Kannospark/Eco-friendly-racing-cars/Final Report & Experience/Study Note/week2/Week_2_Study_Note.pdf

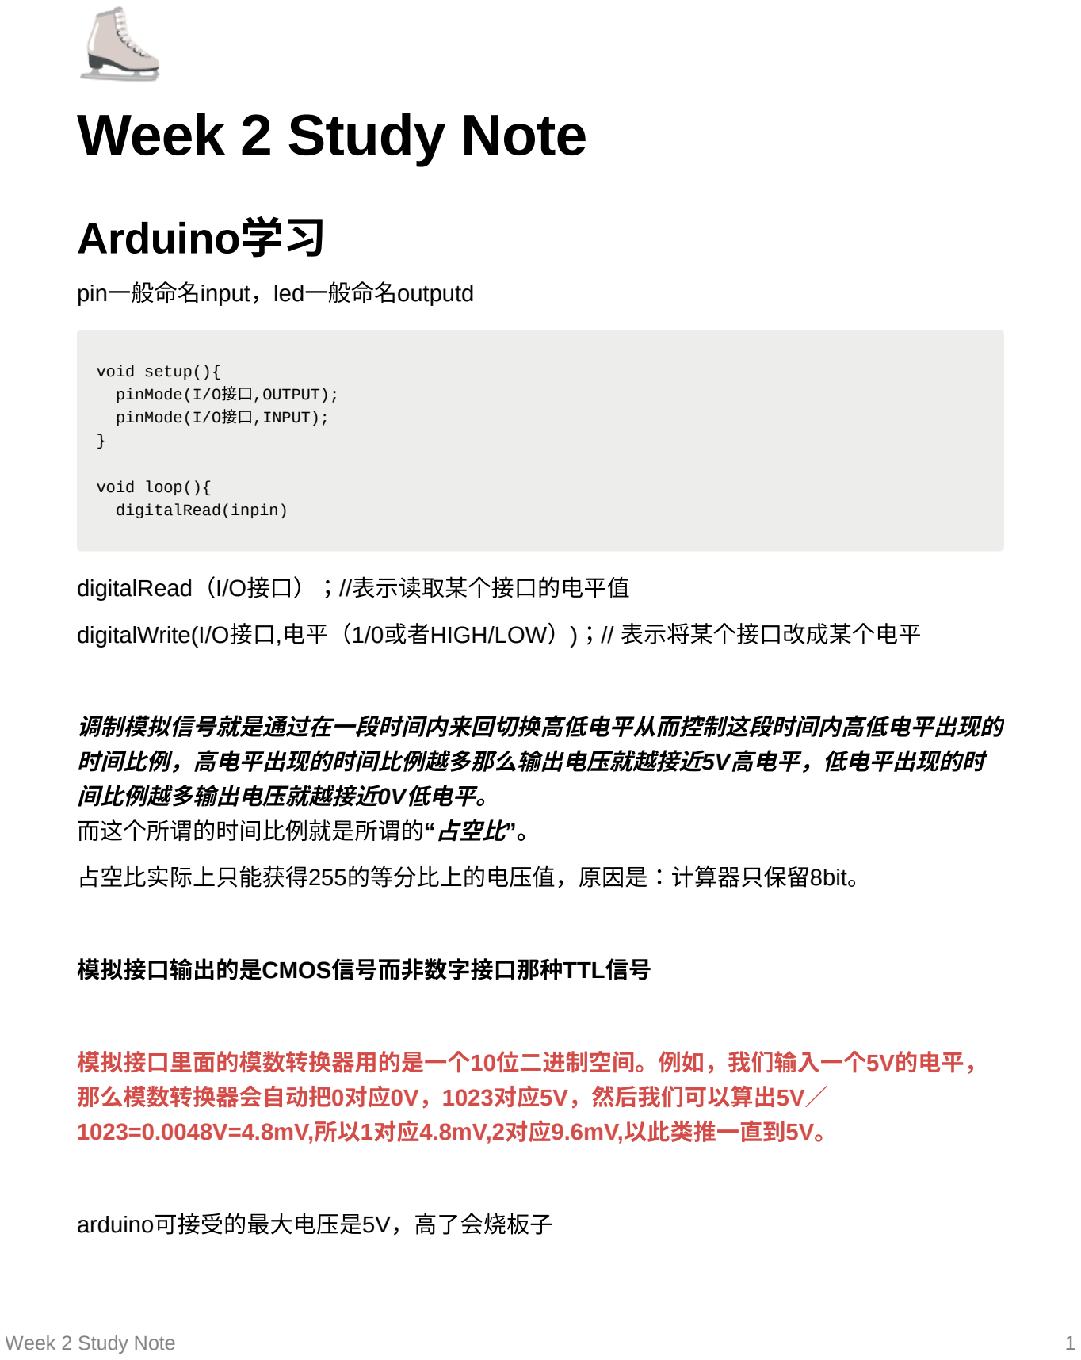
[picture p2: figure]
Week 2 Study Note; Arduino学习; pin⼀般命名input，led⼀般命名outputd; void setup(){ pinMode(I/O接⼝,OUTPUT); pinMode(I/O接⼝,INPUT);; void loop(){ digitalRead(inpin); digitalRead（I/O接⼝）；//表⽰读取某个接⼝的电平值; digitalWrite(I/O接⼝,电平（1/0或者HIGH/LOW）)；// 表⽰将某个接⼝改成某个电平; 调制模拟信号就是通过在⼀段时间内来回切换⾼低电平从⽽控制这段时间内⾼低电平出现的 时间⽐例，⾼电平出现的时间⽐例越多那么输出电压就越接近5V⾼电平，低电平出现的时; 间⽐例越多输出电压就越接近0V低电平。; ⽽这个所谓的时间⽐例就是所谓的“占空⽐”。; 占空⽐实际上只能获得255的等分⽐上的电压值，原因是：计算器只保留8bit。; 模拟接⼝输出的是CMOS信号⽽⾮数字接⼝那种TTL信号; 模拟接⼝⾥⾯的模数转换器⽤的是⼀个10位⼆进制空间。例如，我们输⼊⼀个5V的电平，; 那么模数转换器会⾃动把0对应0V，1023对应5V，然后我们可以算出5V∕ 1023=0.0048V=4.8mV,所以1对应4.8mV,2对应9.6mV,以此类推⼀直到5V。; arduino可接受的最⼤电压是5V，⾼了会烧板⼦

val = analogRead(potpin);//读取传感器的模拟值并赋给val（即将模拟端⼝的电平给val）

波特率也称调制速率是每秒传输的⼆进制数据数⽬，速率是bps，同波特率才可以实现串⼝ 通信

每秒通过信道传输的码元数（码元传输速率），通过不同的调制⽅法可以在⼀个码元上负载 多个⽐特信息 数据信号对载波的调制速率

“波特率”表⽰每秒种传输离散信号事件的个数，或每秒信号电平的变化次数，单位为 band（波特）。即波特率所表⽰的是调制速度，是单位时间内传输线路上调制状态的变化 数。

调制后同⼀时间⾥所包含的数据数量，波特率不同的话数据采集会出错，在单⽚机中若晶振 (https://so.csdn.net/so/search?q=%E5%8D%95%E7%89%87%E6%9C%BA&spm=1001.2101.3001.7020) 采集速度不够的话也会出现数据错误

Serial.begin(); //开启串⾏通信接⼝并设置通信波特率

## ⼩⻋电控遇⻅的问题以及初步解决⽅案

后续想要实现遥控器（⼿柄）控制电机的转速，需要⽤到H桥、控制电路以及升压器。⽬前 组内有很多低内阻（0.1欧）直流电机⽆法使⽤，原因是供电充电宝电压太低导致电流过 ⼤，直流电机⽆法带动。后续需要升压模块进⾏升压。

## 回答SA上课时的⼀些问题

### Question 1 - 第⼀个指令中9600代表波特率。请弄清楚波特率是什么。

void setup(){
Serial.begin(9600);
Serial.println("Hello, SDIM!"); }
- 串⾏通信不是⾃计时的（不同于SPI或I2C等），因此发送⽅和接收⽅都必须就时钟速率达 成共识。

波特率是串⼝通信时的⼀个参数，决定信息传输的速率。9600意味着每秒传输9600个⼆进 制位数、每个数据字节=10⼆进制，所以等于960字节/秒。由于我们默认⼀般都是

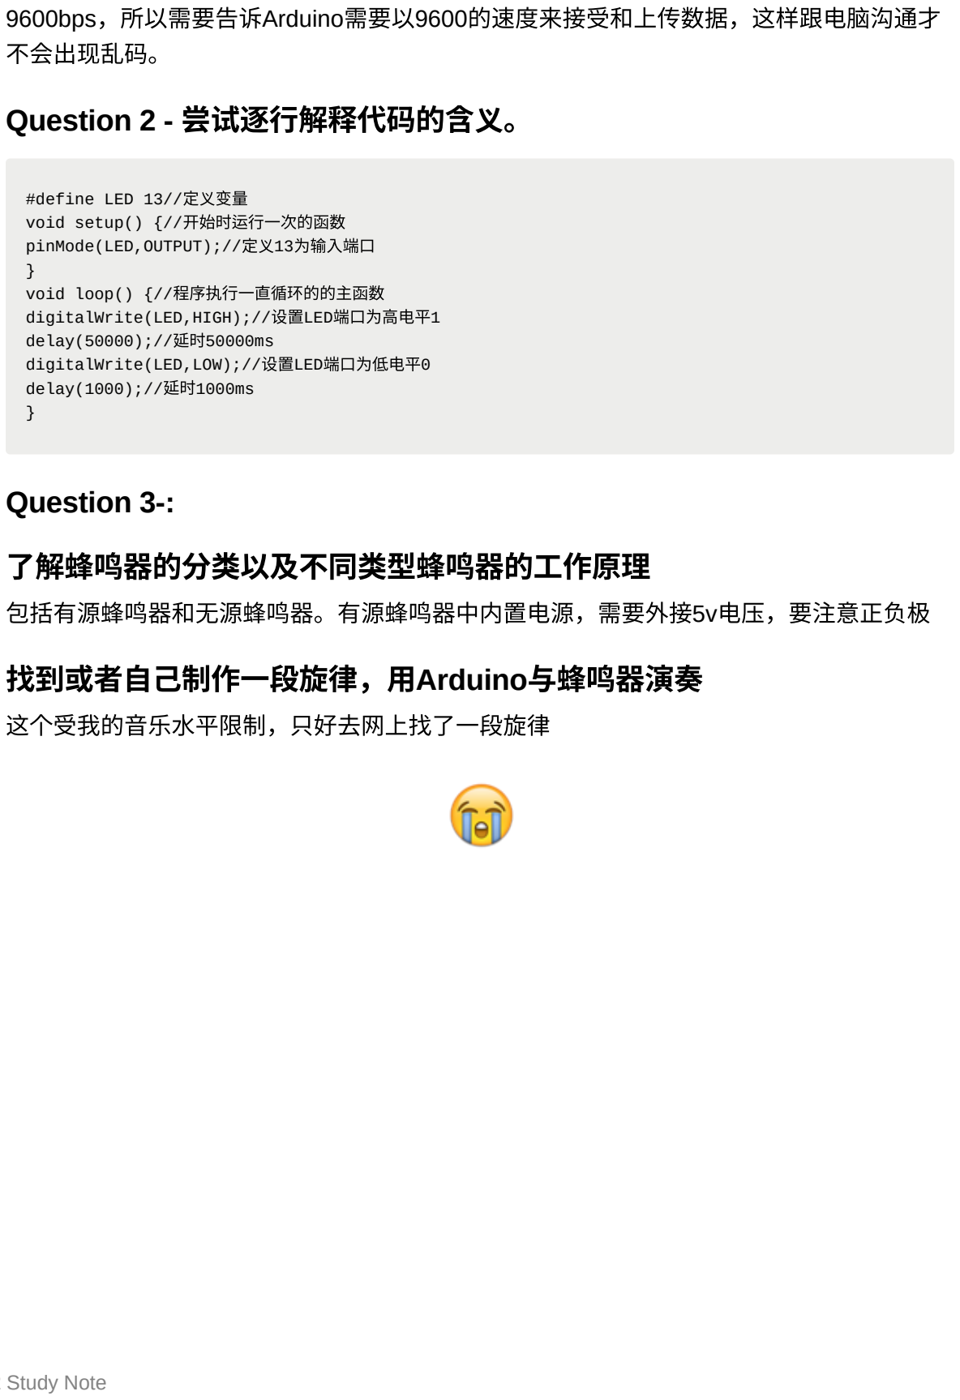
[picture p3: figure]
9600bps，所以需要告诉Arduino需要以9600的速度来接受和上传数据，这样跟电脑沟通才; 不会出现乱码。; Question 2 - 尝试逐⾏解释代码的含义。; #define LED 13//定义变量 void setup() {//开始时运⾏⼀次的函数 pinMode(LED,OUTPUT);//定义13为输⼊端⼝ } void loop() {//程序执⾏⼀直循环的的主函数 digitalWrite(LED,HIGH);//设置LED端⼝为⾼电平1 delay(50000);//延时50000ms digitalWrite(LED,LOW);//设置LED端⼝为低电平0 delay(1000);//延时1000ms }; Question 3-:; 了解蜂鸣器的分类以及不同类型蜂鸣器的⼯作原理; 包括有源蜂鸣器和⽆源蜂鸣器。有源蜂鸣器中内置电源，需要外接5v电压，要注意正负极; 找到或者⾃⼰制作⼀段旋律，⽤Arduino与蜂鸣器演奏; 这个受我的⾳乐⽔平限制，只好去⽹上找了⼀段旋律

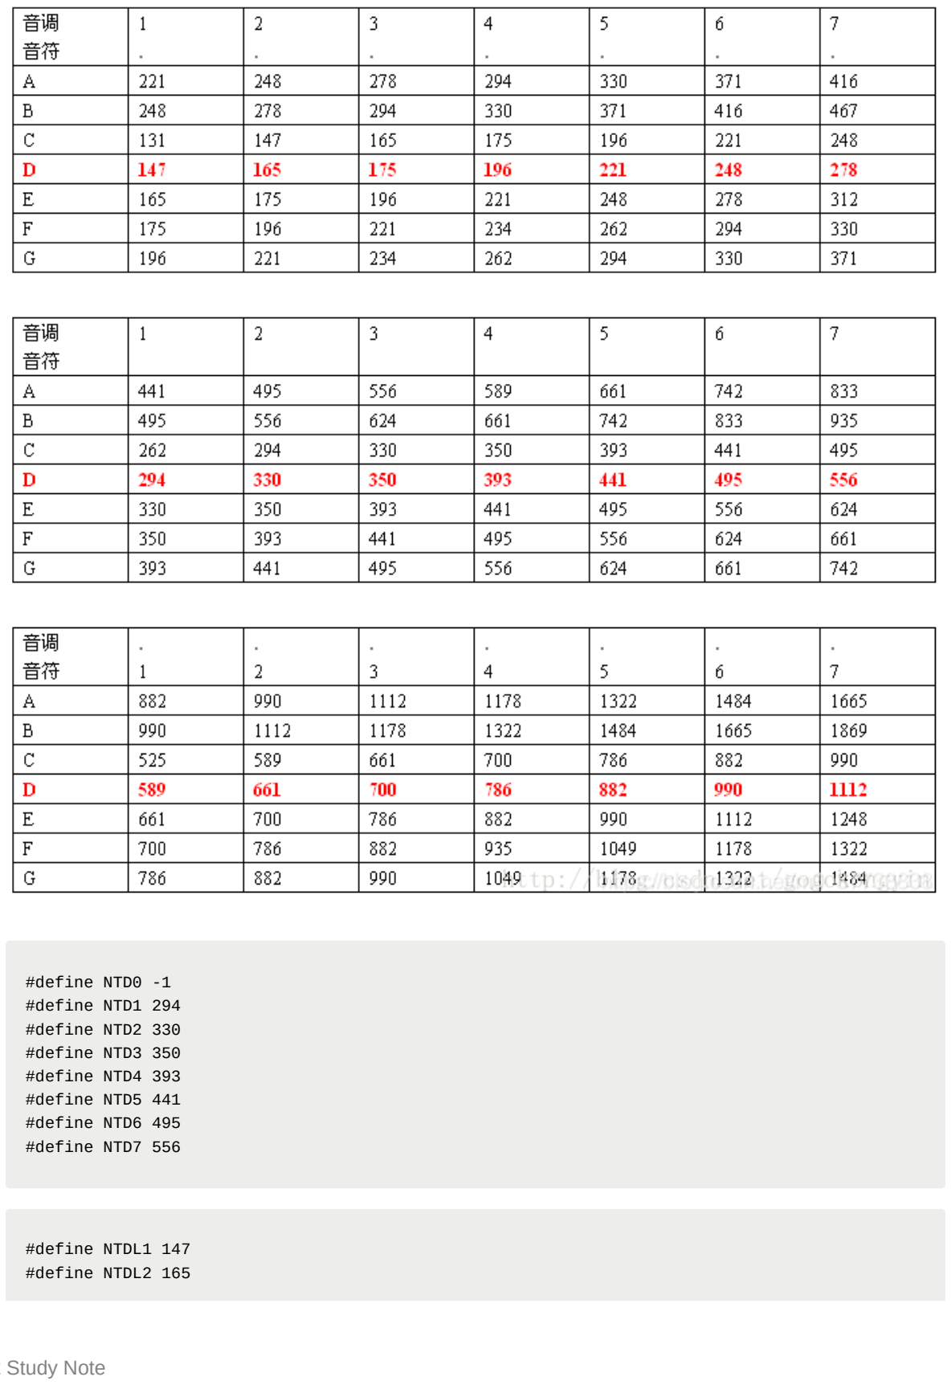
[picture p4: figure]
#define NTD0 -1 #define NTD1 294 #define NTD2 330 #define NTD3 350 #define NTD4 393 #define NTD5 441 #define NTD6 495 #define NTD7 556; #define NTDL1 147 #define NTDL2 165

#define NTDL3 175

#define NTDL4 196

#define NTDL5 221

#define NTDL6 248

#define NTDL7 278

#define NTDH1 589

#define NTDH2 661

#define NTDH3 700

#define NTDH4 786

#define NTDH5 882

#define NTDH6 990

#define NTDH7 112

//列出全部D调的频率
#define WHOLE 1

#define HALF 0.5

#define QUARTER 0.25

#define EIGHTH 0.25

#define SIXTEENTH 0.625

//列出所有节拍
int tune[]= | //根据简谱列出各频率
{
NTD3,NTD3,NTD4,NTD5,
NTD5,NTD4,NTD3,NTD2,
NTD1,NTD1,NTD2,NTD3,
NTD3,NTD2,NTD2,
NTD3,NTD3,NTD4,NTD5,
NTD5,NTD4,NTD3,NTD2,
NTD1,NTD1,NTD2,NTD3,
NTD2,NTD1,NTD1,
NTD2,NTD2,NTD3,NTD1,
NTD2,NTD3,NTD4,NTD3,NTD1,
NTD2,NTD3,NTD4,NTD3,NTD2,
NTD1,NTD2,NTDL5,NTD0,
NTD3,NTD3,NTD4,NTD5,
NTD5,NTD4,NTD3,NTD4,NTD2,
NTD1,NTD1,NTD2,NTD3,
NTD2,NTD1,NTD1
};
float durt[]= | //根据简谱列出各节拍
{
1,1,1,1,
1,1,1,1,
1,1,1,1,
1+0.5,0.5,1+1,
1,1,1,1,
1,1,1,1,
1,1,1,1,
1+0.5,0.5,1+1,
1,1,1,1,
1,0.5,0.5,1,1,
1,0.5,0.5,1,1,
1,1,1,1,

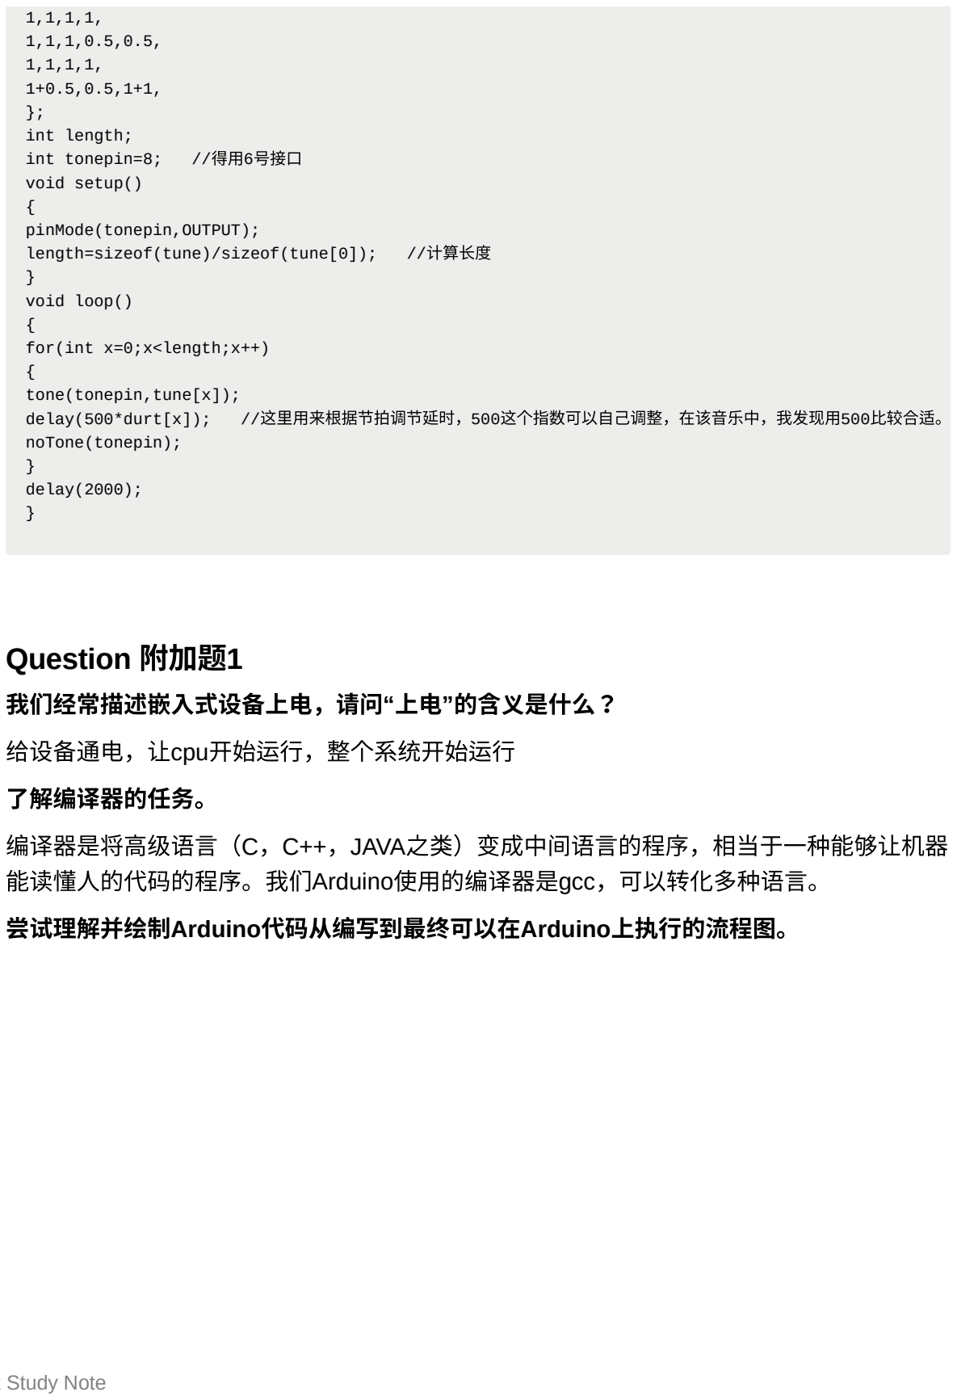
[picture p5: figure]
1,1,1,1, 1,1,1,0.5,0.5, 1,1,1,1, 1+0.5,0.5,1+1, }; int length;; int tonepin=8;; void setup() { pinMode(tonepin,OUTPUT);; length=sizeof(tune)/sizeof(tune[0]);; } void loop() { for(int x=0;x<length;x++) { tone(tonepin,tune[x]);; delay(500*durt[x]);; //这⾥⽤来根据节拍调节延时，500这个指数可以⾃⼰调整，在该⾳乐中，我发现⽤500⽐较合适。; noTone(tonepin); } delay(2000); }; Question 附加题1; 我们经常描述嵌⼊式设备上电，请问“上电”的含义是什么？; 给设备通电，让cpu开始运⾏，整个系统开始运⾏; 了解编译器的任务。; 编译器是将⾼级语⾔（C，C++，JAVA之类）变成中间语⾔的程序，相当于⼀种能够让机器; 能读懂⼈的代码的程序。我们Arduino使⽤的编译器是gcc，可以转化多种语⾔。; 尝试理解并绘制Arduino代码从编写到最终可以在Arduino上执⾏的流程图。

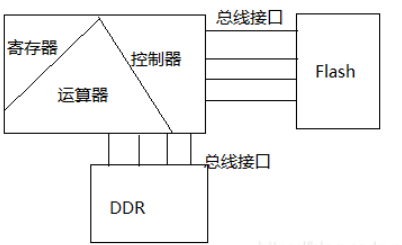
[picture p6: figure]

⾸先，程序以机器码的形式，即⼆进制码的形式存在FLASH中；

上电后，CPU通过控制器将待运⾏的程序从FLASH中读⼊内存中；

代码在内存中运⾏时，控制器将需要计算的数据存⼊寄存器中；

运算器从寄存器中读取数据进⾏运算，并将结果存⼊寄存器中；

控制器将寄存器中的结果读⼊内存中；

由此，形成⼀个闭环的程序运⾏过程。
————————————————
版权声明：本⽂为CSDN博主「Clearfix_Xia」的原创⽂章，遵循CC 4.0 BY-SA版权协议， 转载请附上原⽂出处链接及本声明。
原⽂链接：https://blog.csdn.net/csdnxmj/article/details/103809310

## Question 附加题2

关于PWM的学习资料

PWM就是通过调整直流电压占空⽐，来实现调节电压值的效果。

# SW学习

本周⽼师在课上交了我们如何使⽤Solidworks 3D绘图软件，他可以让我们很好的制作零部 件进⾏3D打印，是个很⽅便使⽤的⼯具。在完成课上任务后，我在课下完成了两幅图的绘 制。不得不说，软件虽然看起来很⿇烦，但是实际上⼿操作了两次之后，就感觉⼤概学会了 基本的使⽤⽅法。我画零件的⼤概流程是：先将零件的某个特征画出来，再讲零件的整个体 粗略画出来，然后慢慢抠出细节

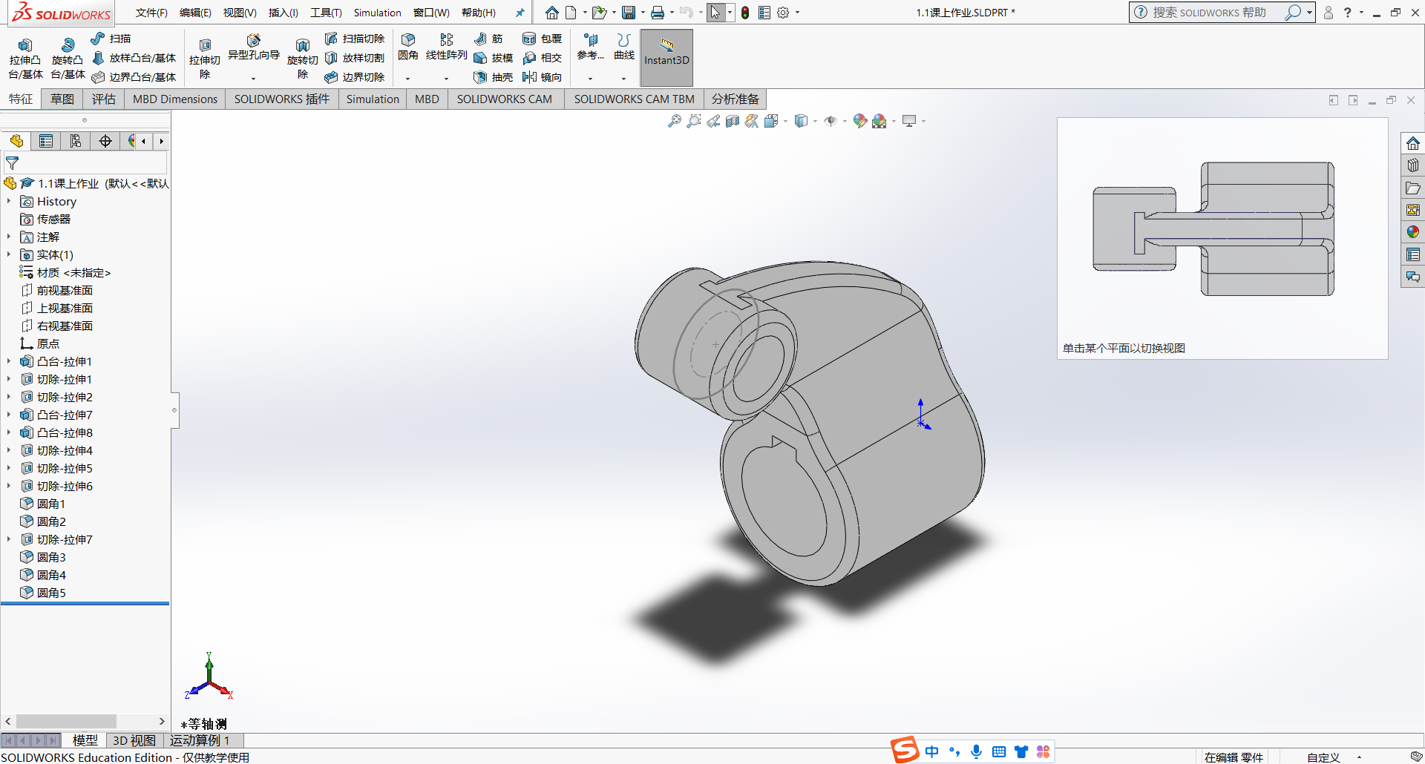
[picture p7: figure]

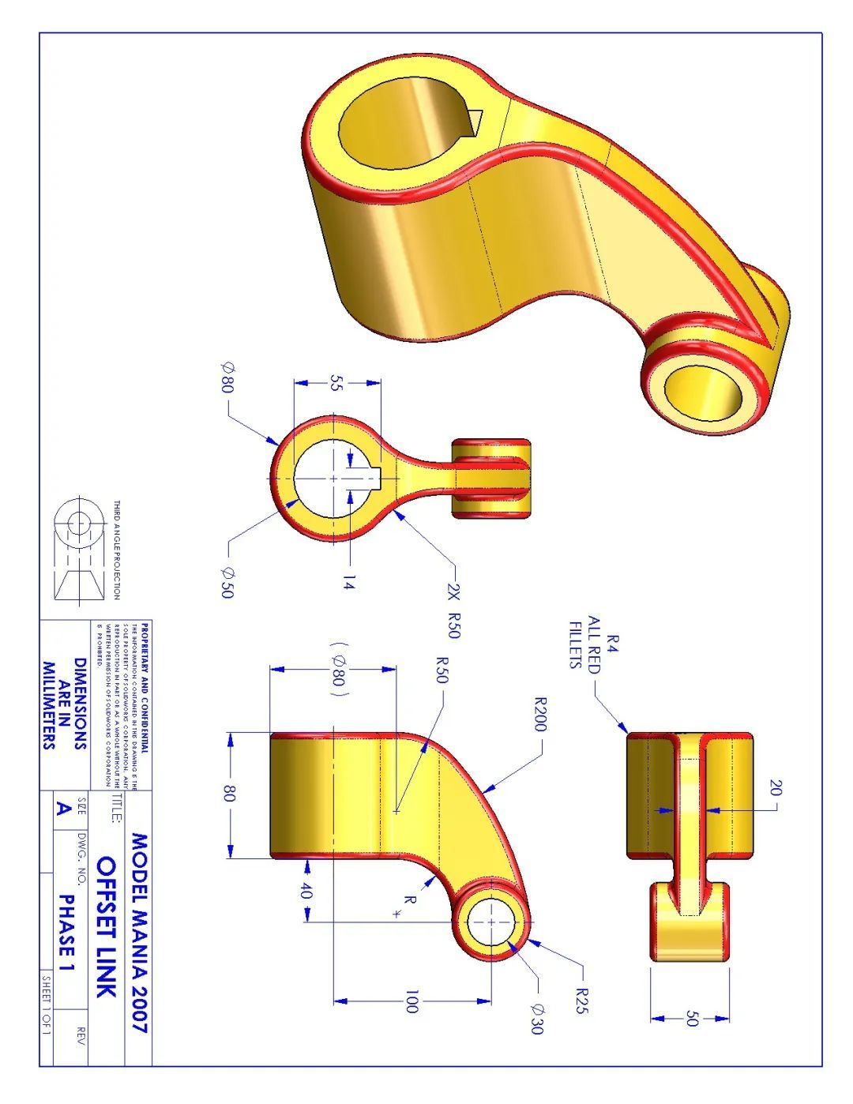
[picture p8: figure]

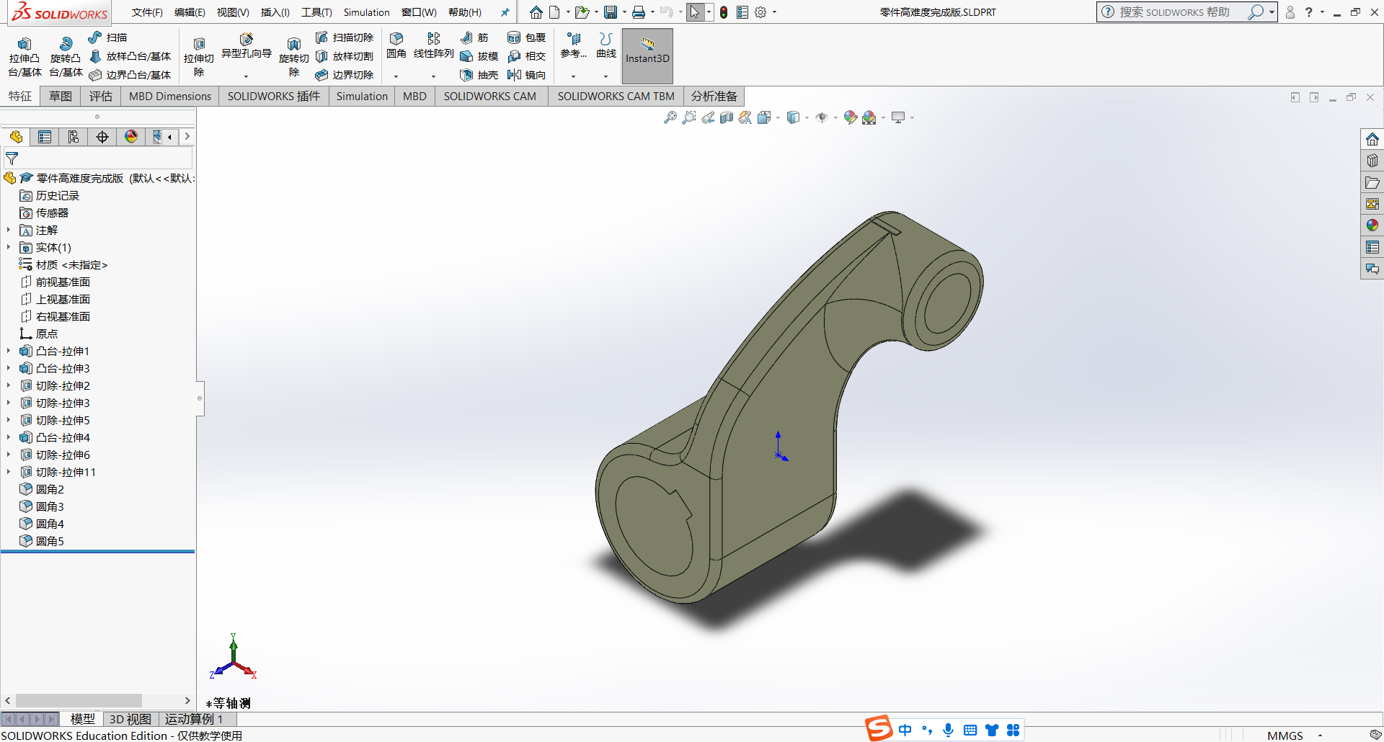
[picture p9: figure]

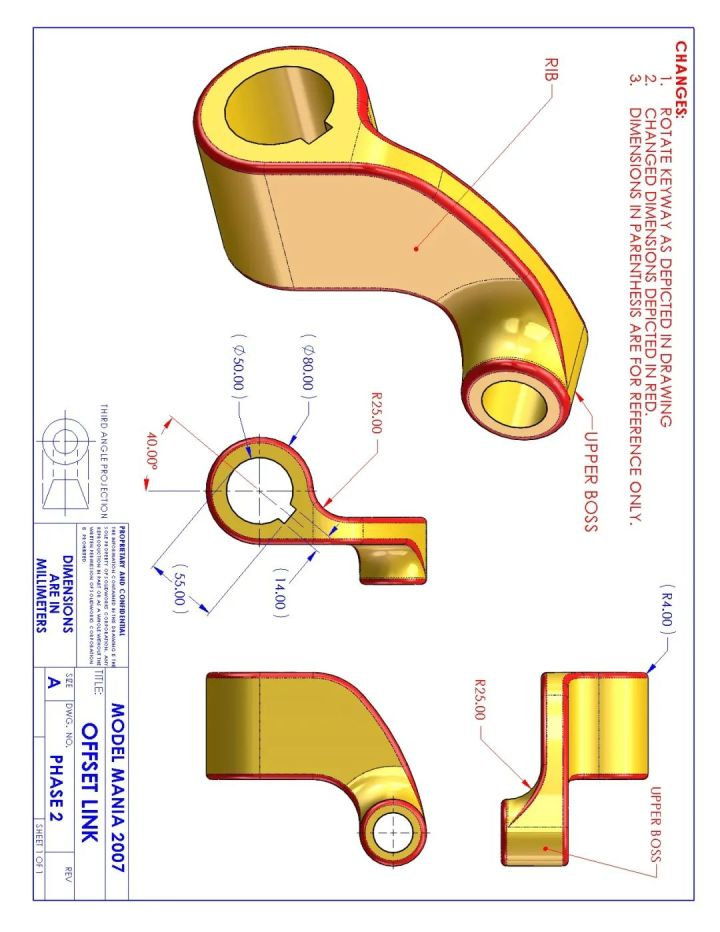
[picture p10: figure]

实际画了两幅图之后，觉得画图还是件蛮有意思的⼯作

# 本周⼯作总结

本周完成了第⼀代⼩⻋的模型，虽然做的很简陋，但是让我们初步对于⼩⻋的概念有所理解

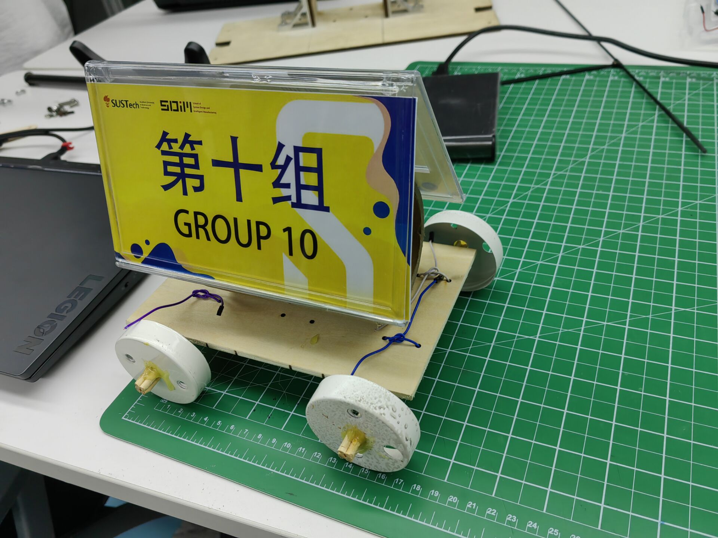
[picture p11: figure]

# 课上3D⼩⻋制作展⽰

我们组根据海绵宝宝的主题设计了这款“菠萝⻋”，外形如下

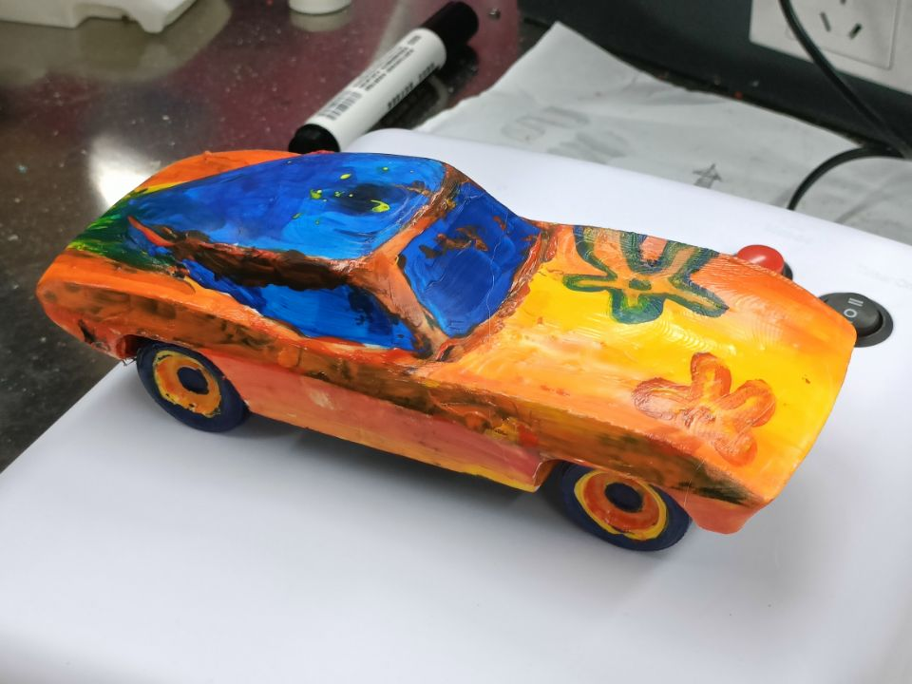
[picture p12: figure]

# 关于下周⼯作内容的讨论

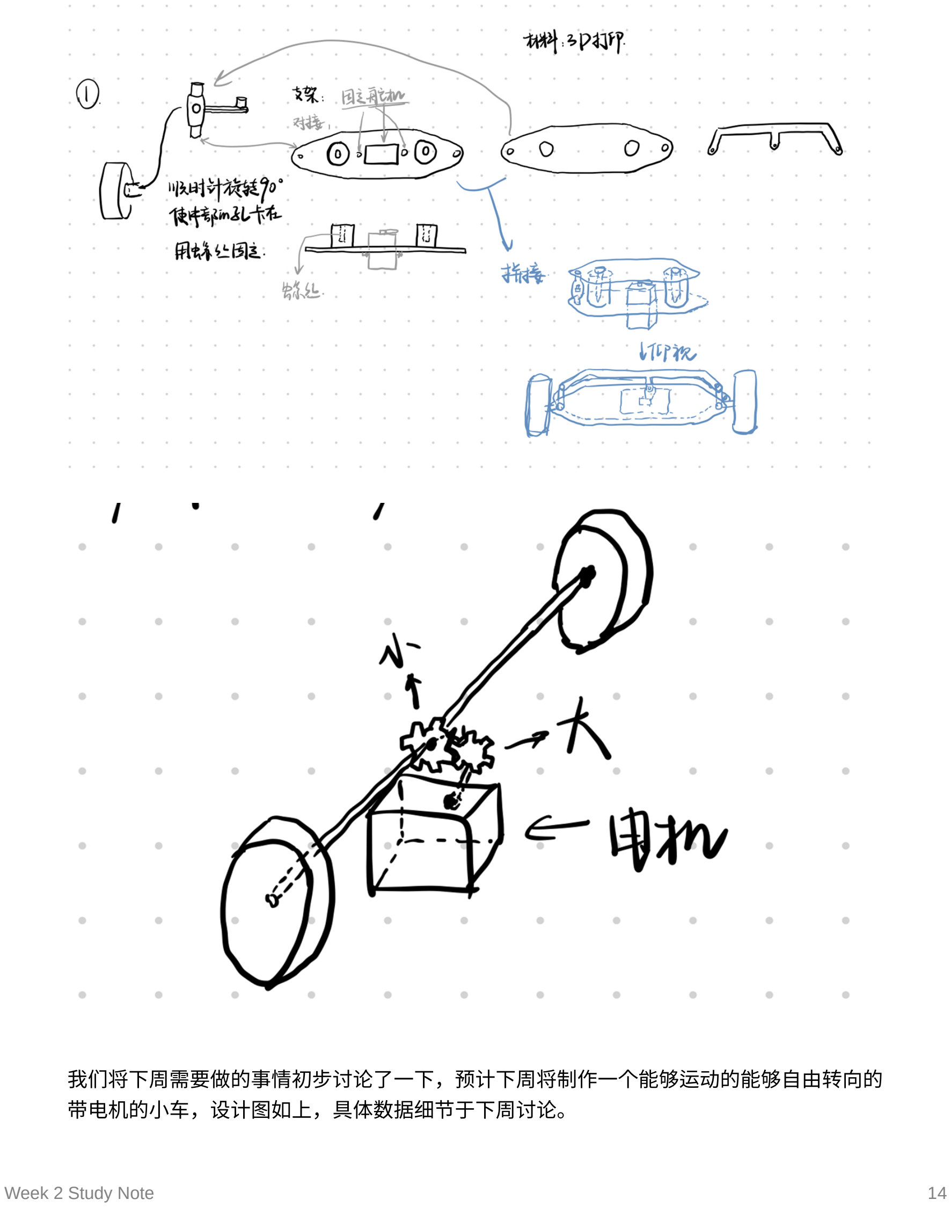
[picture p13: page 14]

我们将下周需要做的事情初步讨论了⼀下，预计下周将制作⼀个能够运动的能够⾃由转向的 带电机的⼩⻋，设计图如上，具体数据细节于下周讨论。
