Kannospark/Eco-friendly-racing-cars/Final Report & Experience/Study Note/week4/SDM101_12112707_钟梓轩_第4周作业_20220724.pdf

Week4 study notes | 1

# Week4 study notes

# 超声测距模块

## 模块引脚

## 超声波模块有4个引脚，分别为Vcc、 Trig（控制端）、 Echo（接收端）、 GND；其中VCC、GND 接上5V电源， Trig（控制端）控制发出的超声波信号，Echo（接收端）接收反射回来的超声波信 号。模块如图：

## 控制原理

## 通过Trig引脚发⼀个 10US 以上的⾼电平,就可以在Echo接收⼝等待⾼电平输出；⼀有输出就可以开定 时器计时,当此⼝变为低电平时就可以读定时器的值,此时就为此次测距的时间,⽅可算出距离.如此不断 的周期测,就可以达到你移动测量的值了。

## ⼯作流程

a.单⽚机引脚触发Trig测距，给⾄少 10us 的⾼电平信号;

## b.模块⾃动发送 8 个 40khz 的⽅波，⾃动检测是否有信号返回；

c.有信号返回，通过 IO 输出⼀⾼电平，并单⽚机定时器计算⾼电平持续的时间;

## d.超声波从发射到返回的时间．

计算公式：测试距离=(⾼电平时间*声速(340M/S))/2;

## 在学习之后，我将代码改编了⼀下加⼊了第三周⼩⻋控制系统之中。我⾸先在第三周⼩⻋的右侧加装 了超声波测距仪HC-HR04，然后在主控板上加⼊了如下代码

boolean AIdrive;

void loop(){
if(ps2x.ButtonPressed(PSB_TRIANGLE)){//按下三⾓后转变AIdrive的状态 AIdrive = !AIdrive;
}

if(!AIdrive){ //⾮AI状态下⼿动控制
read(); //电机驱动
if(ps2x.ButtonPressed(PSB_CIRCLE) && turnOnMusic ) { //⾳乐驱动 musicOpen();
turnOnMusic = !turnOnMusic;
}
if(ps2x.ButtonPressed(PSB_CIRCLE) && !turnOnMusic) {

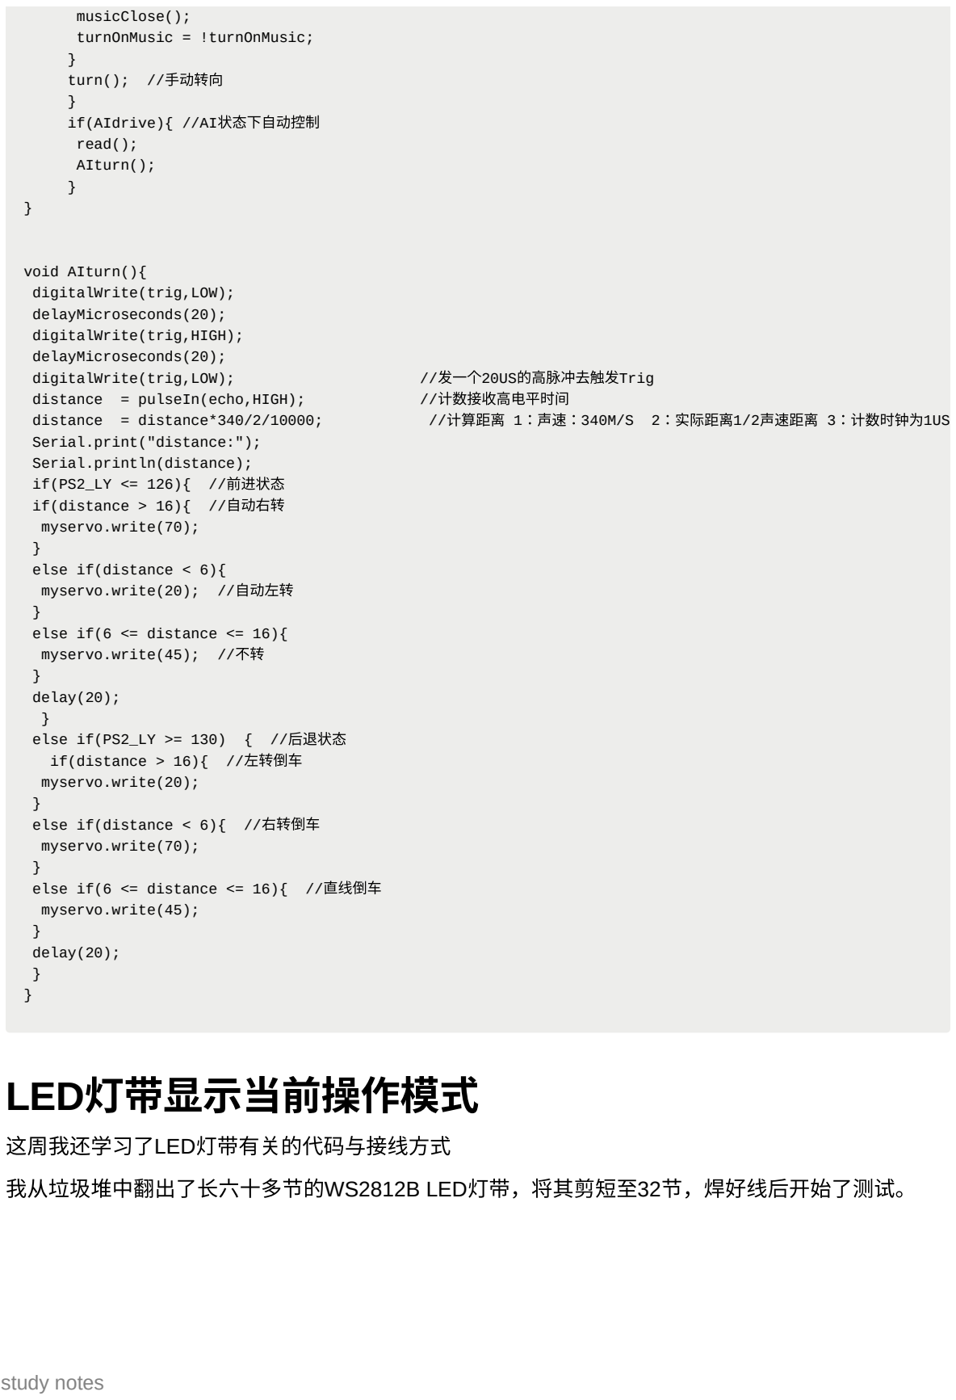
[picture p14: figure]
musicClose(); turnOnMusic = !turnOnMusic; } turn(); //⼿动转向 } if(AIdrive){ //AI状态下⾃动控制 read(); AIturn(); }; void AIturn(){ digitalWrite(trig,LOW); delayMicroseconds(20); digitalWrite(trig,HIGH); delayMicroseconds(20);; digitalWrite(trig,LOW);; //发⼀个20US的⾼脉冲去触发Trig; distance = pulseIn(echo,HIGH);; //计数接收⾼电平时间; distance = distance*340/2/10000;; //计算距离 1：声速：340M/S 2：实际距离1/2声速距离 3：计数时钟为1US; Serial.print("distance:"); Serial.println(distance); if(PS2_LY <= 126){ //前进状态 if(distance > 16){ //⾃动右转 myservo.write(70); } else if(distance < 6){ myservo.write(20)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

## 我从垃圾堆中翻出了⻓六⼗多节的WS2812B LED灯带，将其剪短⾄32节，焊好线后开始了测试。

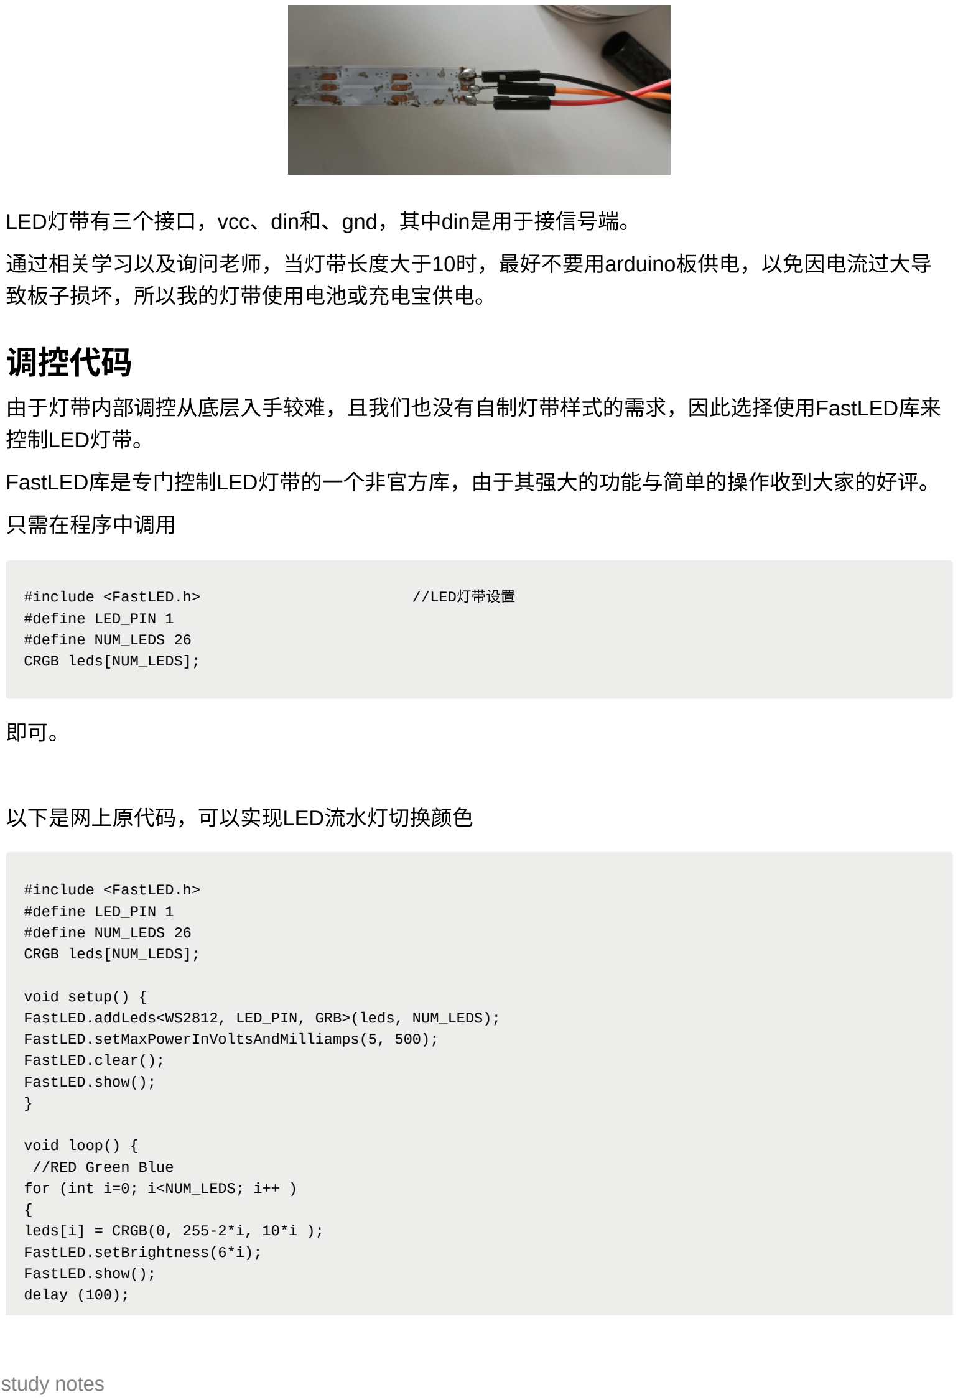
[picture p15: figure]
LED灯带有三个接⼝，vcc、din和、gnd，其中din是⽤于接信号端。; 致板⼦损坏，所以我的灯带使⽤电池或充电宝供电。; 调控代码; 控制LED灯带。; 只需在程序中调⽤; #include <FastLED.h>; //LED灯带设置; #define LED_PIN 1 #define NUM_LEDS 26 CRGB leds[NUM_LEDS];; 以下是⽹上原代码，可以实现LED流⽔灯切换颜⾊; #include <FastLED.h> #define LED_PIN 1 #define NUM_LEDS 26 CRGB leds[NUM_LEDS];; void setup() { FastLED.addLeds<WS2812, LED_PIN, GRB>(leds, NUM_LEDS); FastLED.setMaxPowerInVoltsAndMilliamps(5, 500); FastLED.clear(); FastLED.show(); }; void loop() { //RED Green Blue for (int i=0; i<NUM_LEDS; i++ ) { leds[i] = CRGB(0, 255-2*i, 10*i ); FastLED.setBrightness(6*i); FastLED.show(); delay (100);

## 通过相关学习以及询问⽼师，当灯带⻓度⼤于10时，最好不要⽤arduino板供电，以免因电流过⼤导

## 由于灯带内部调控从底层⼊⼿较难，且我们也没有⾃制灯带样式的需求，因此选择使⽤FastLED库来

## FastLED库是专门控制LED灯带的⼀个⾮官⽅库，由于其强⼤的功能与简单的操作收到⼤家的好评。

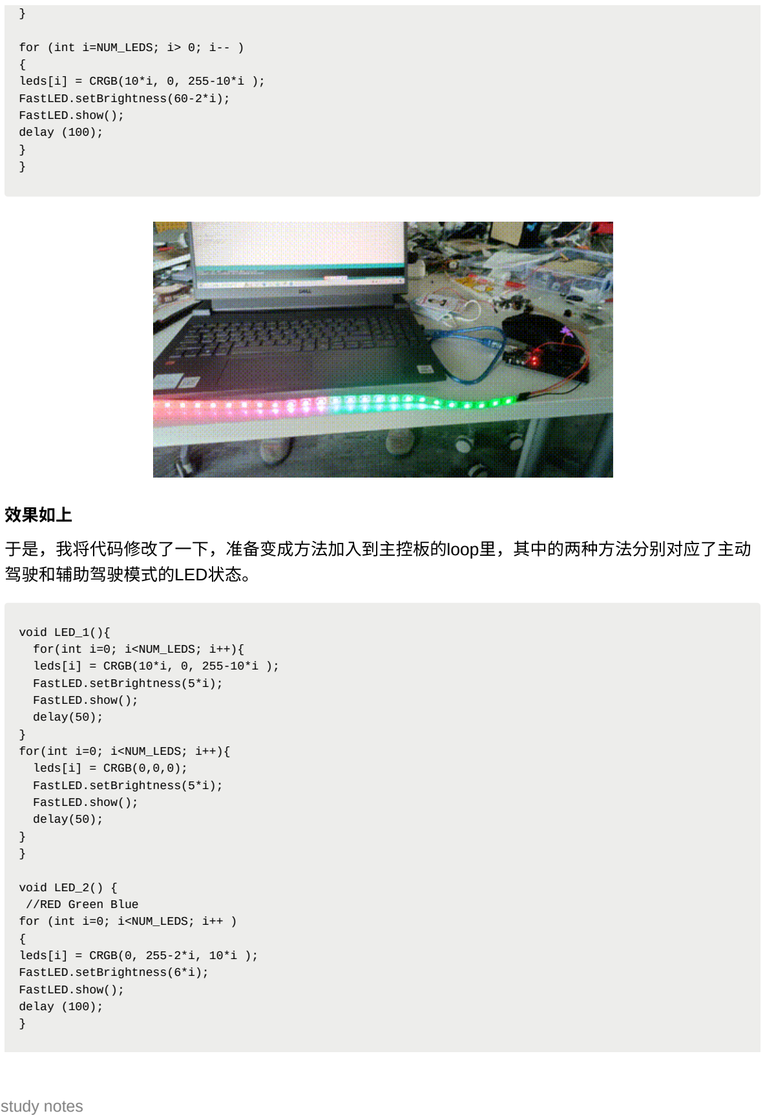
[picture p16: figure]
for (int i=NUM_LEDS; i> 0; i-- ) { leds[i] = CRGB(10*i, 0, 255-10*i ); FastLED.setBrightness(60-2*i); FastLED.show(); delay (100); } }; 效果如上; 驾驶和辅助驾驶模式的LED状态。; void LED_1(){ for(int i=0; i<NUM_LEDS; i++){ leds[i] = CRGB(10*i, 0, 255-10*i ); FastLED.setBrightness(5*i); FastLED.show(); delay(50);; } for(int i=0; i<NUM_LEDS; i++){ leds[i] = CRGB(0,0,0); FastLED.setBrightness(5*i); FastLED.show(); delay(50);; void LED_2() { //RED Green Blue for (int i=0; i<NUM_LEDS; i++ ) { leds[i] = CRGB(0, 255-2*i, 10*i ); FastLED.setBrightness(6*i); FastLED.show(); delay (100); }

## 于是，我将代码修改了⼀下，准备变成⽅法加⼊到主控板的loop⾥，其中的两种⽅法分别对应了主动

for (int i=NUM_LEDS; i> 0; i-- ) {
leds[i] = CRGB(10*i, 0, 255-10*i ); FastLED.setBrightness(60-2*i); FastLED.show();
delay (100);
}

## 虽然看起来很完美⽆缺，但当我烧录到arduino板后，发现舵机变得不太对劲，具体提现是没过⼏秒他 就会⾃动转⼀下，⽽且不受控制。在搜索原因后，我发现可能是因为delay函数的频繁使⽤导致出现了 看门狗现象。

## 看门狗是⼀个定时器电路, ⼀般有⼀个输⼊,叫喂狗,⼀个输出到MCU的RST端,MCU正常⼯作的时候,每 隔⼀段时间输出⼀个信号到喂狗端,给 WDT 清零,如果超过规定的时间不喂狗,(⼀般在程序跑⻜ 时),WDT 定时超过,就回给出⼀个复位信号到MCU,使MCU复位。防⽌MCU死机，看门狗的作⽤就是 (https://link.zhihu.com/) 防⽌程序发⽣死循环，或者说程序跑⻜。

## 在思考过后，我认为⼀块Arduino开发板不⾜以同时驱动电机舵机同时驱动LED，因此，我决定再买⼀ 块板⼦Arduino nano板（⽐较⼩）当做副控制板，专门控制LED灯。⽬前板⼦还没到，因此下周我将 把这个计划实现。

# 电磁炮发射功能的学习

## 在本周开始时的会议上，我们讨论了关于⼩⻋到达5m/s的⽅案，其中我们特地讨论了⼀下电磁炮或者 ⾼斯炮的可能性。

## 在接下来⼀天中，我学习了许多有关电磁炮的相关知识，并对可⾏性进⾏了计算

## 已知B＝μ0nI，其中n是匝密度，μ0=4π×10-7，假设螺线管⻓10cm，电流1A，那么1T需要80000圈

## （每跟管⼦），然后管⼦上的线圈要闭合，⻋⼦上需要⼀个⻓10cm通2A电流的导线，产⽣ F=BIL=0.2N。这点⼒太⼩了，⽽我们需要做的努⼒却太多了，因此，在计算后我们放弃了电磁炮这个

⽅案。

## 关于⾼斯炮，我们认为这个⽅案可⾏

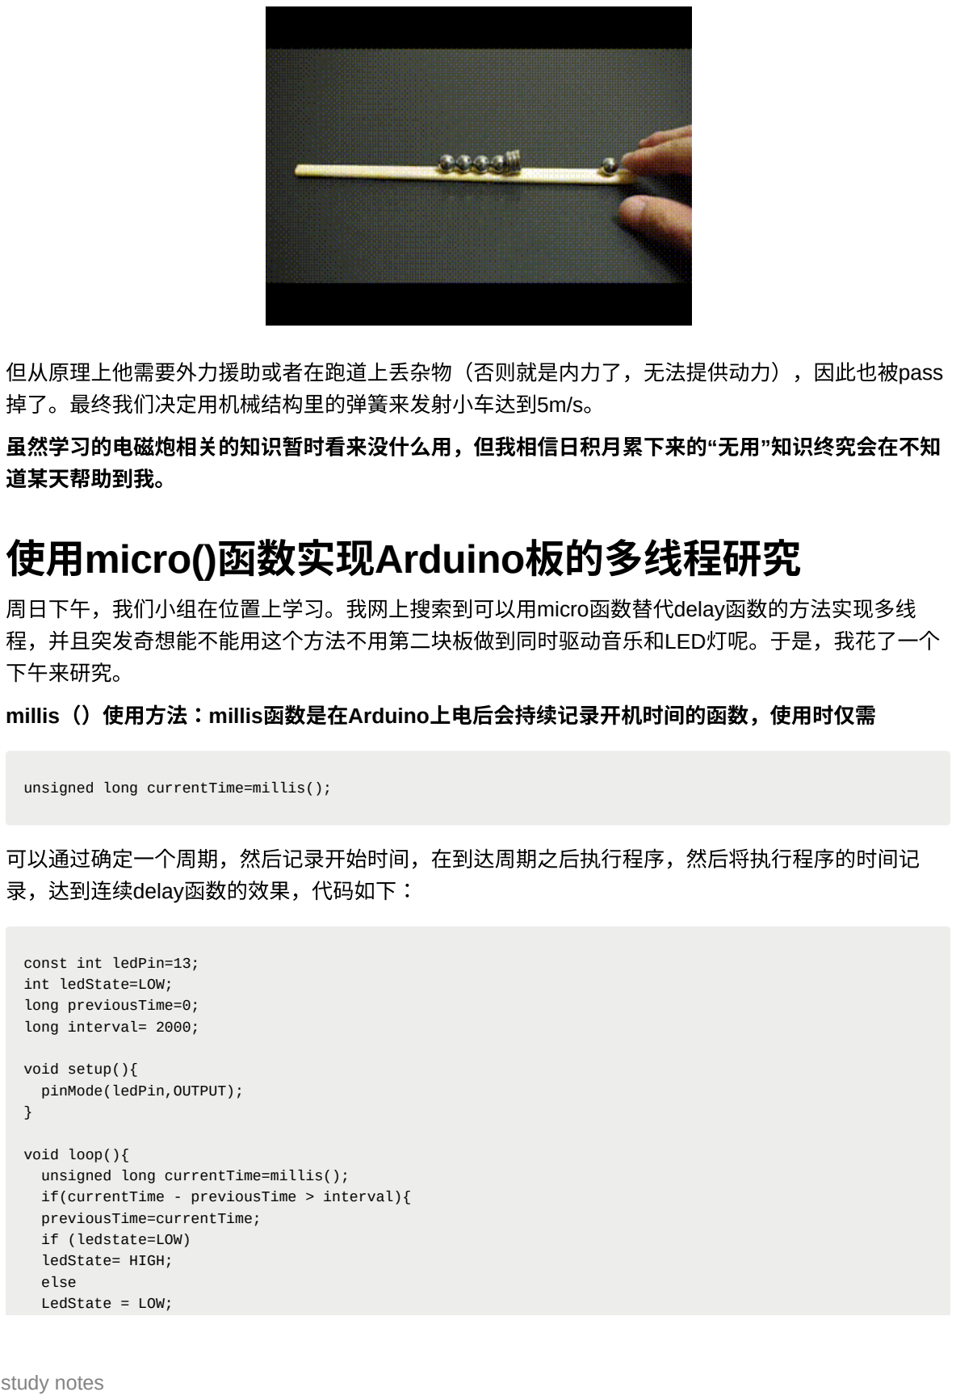
[picture p17: figure]
掉了。最终我们决定⽤机械结构⾥的弹簧来发射⼩⻋达到5m/s。; 道某天帮助到我。; 使⽤micro()函数实现Arduino板的多线程研究; 下午来研究。; unsigned long currentTime=millis();; 录，达到连续delay函数的效果，代码如下：; const int ledPin=13; int ledState=LOW; long previousTime=0; long interval= 2000;; void setup(){ pinMode(ledPin,OUTPUT);; void loop(){ unsigned long currentTime=millis(); if(currentTime - previousTime > interval){ previousTime=currentTime; if (ledstate=LOW) ledState= HIGH; else LedState = LOW;

## 但从原理上他需要外⼒援助或者在跑道上丢杂物（否则就是内⼒了，⽆法提供动⼒），因此也被pass

## 虽然学习的电磁炮相关的知识暂时看来没什么⽤，但我相信⽇积⽉累下来的“⽆⽤”知识终究会在不知

## 周⽇下午，我们⼩组在位置上学习。我⽹上搜索到可以⽤micro函数替代delay函数的⽅法实现多线 程，并且突发奇想能不能⽤这个⽅法不⽤第⼆块板做到同时驱动⾳乐和LED灯呢。于是，我花了⼀个

## millis（）使⽤⽅法：millis函数是在Arduino上电后会持续记录开机时间的函数，使⽤时仅需

## 可以通过确定⼀个周期，然后记录开始时间，在到达周期之后执⾏程序，然后将执⾏程序的时间记

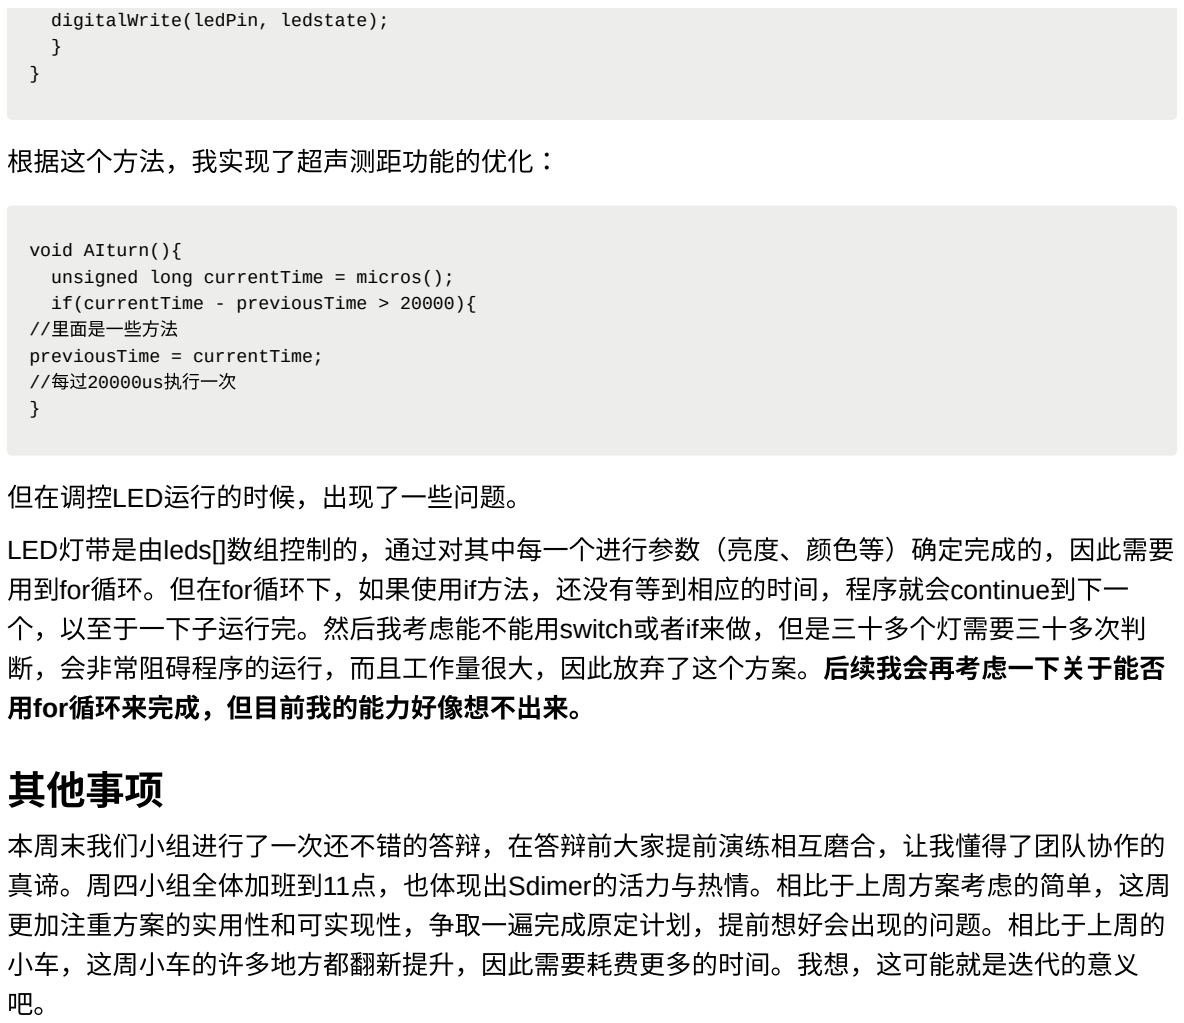
[picture p18: figure]
digitalWrite(ledPin, ledstate); }; 根据这个⽅法，我实现了超声测距功能的优化：; void AIturn(){ unsigned long currentTime = micros(); if(currentTime - previousTime > 20000){ //⾥⾯是⼀些⽅法 previousTime = currentTime; //每过20000us执⾏⼀次 }; 但在调控LED运⾏的时候，出现了⼀些问题。; ⽤for循环来完成，但⽬前我的能⼒好像想不出来。; 其他事项

## LED灯带是由leds[]数组控制的，通过对其中每⼀个进⾏参数（亮度、颜⾊等）确定完成的，因此需要 ⽤到for循环。但在for循环下，如果使⽤if⽅法，还没有等到相应的时间，程序就会continue到下⼀ 个，以⾄于⼀下⼦运⾏完。然后我考虑能不能⽤switch或者if来做，但是三⼗多个灯需要三⼗多次判 断，会⾮常阻碍程序的运⾏，⽽且⼯作量很⼤，因此放弃了这个⽅案。后续我会再考虑⼀下关于能否

## 本周末我们⼩组进⾏了⼀次还不错的答辩，在答辩前⼤家提前演练相互磨合，让我懂得了团队协作的 真谛。周四⼩组全体加班到11点，也体现出Sdimer的活⼒与热情。相⽐于上周⽅案考虑的简单，这周 更加注重⽅案的实⽤性和可实现性，争取⼀遍完成原定计划，提前想好会出现的问题。相⽐于上周的 ⼩⻋，这周⼩⻋的许多地⽅都翻新提升，因此需要耗费更多的时间。我想，这可能就是迭代的意义
