Kannospark/Eco-friendly-racing-cars/Final Report & Experience/Study Note/week1/SDM101_12112707_钟梓轩_第1周作业_20220703.pdf

# Week 1 Study notes

# 汽⻋美学及草图画法

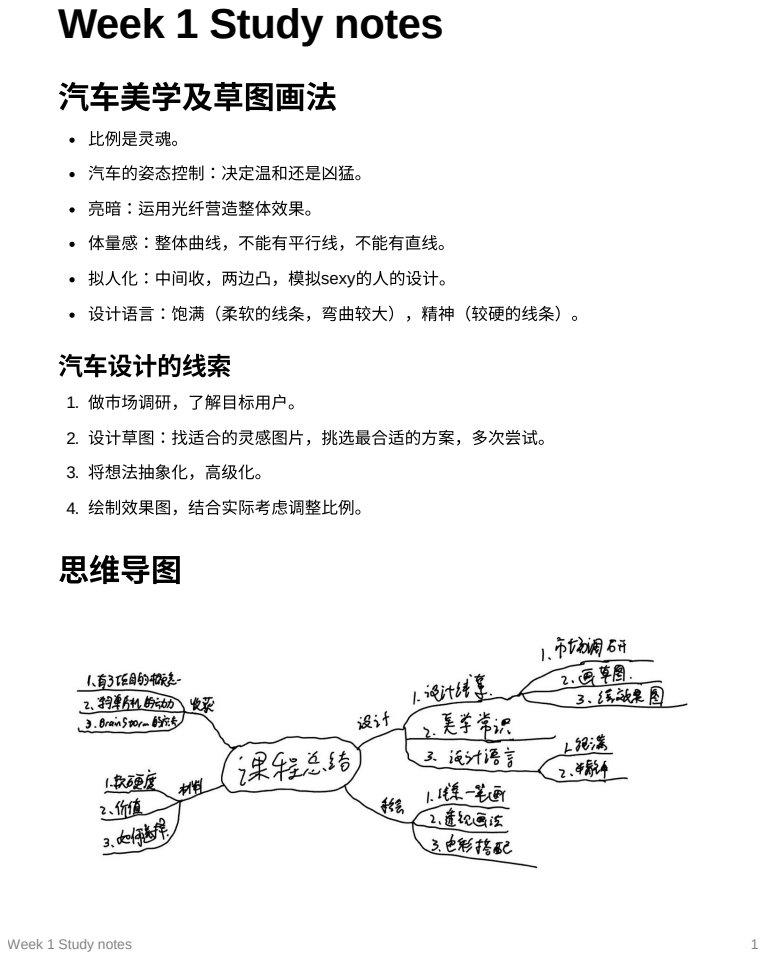
[picture p19: page 1]
Week 1 Study notes; ⽐例是灵魂。; 汽⻋的姿态控制：决定温和还是凶猛。; 亮暗：运⽤光纤营造整体效果。; 汽⻋设计的线索; 1. 做市场调研，了解⽬标⽤户。; 3. 将想法抽象化，⾼级化。; 4. 绘制效果图，结合实际考虑调整⽐例。; 思维导图

体量感：整体曲线，不能有平⾏线，不能有直线。

拟⼈化：中间收，两边凸，模拟sexy的⼈的设计。

设计语⾔：饱满（柔软的线条，弯曲较⼤），精神（较硬的线条）。

2. 设计草图：找适合的灵感图⽚，挑选最合适的⽅案，多次尝试。

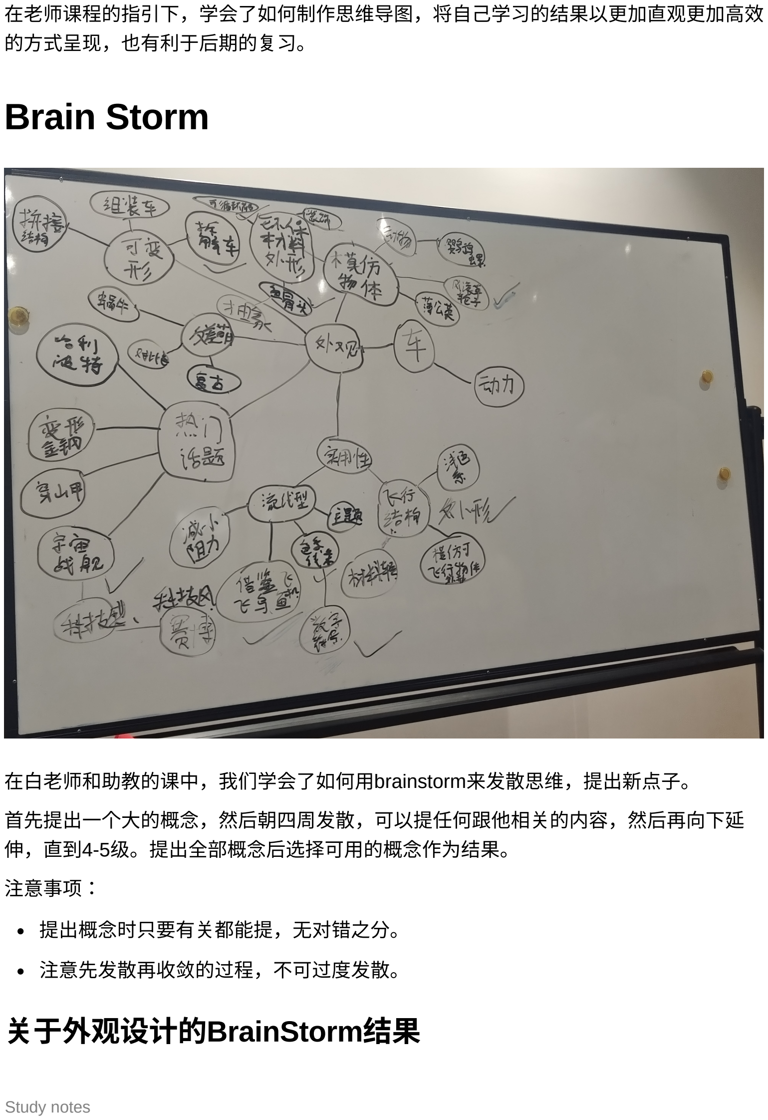
[picture p20: figure]
在⽼师课程的指引下，学会了如何制作思维导图，将⾃⼰学习的结果以更加直观更加⾼效; 的⽅式呈现，也有利于后期的复习。; Brain Storm; 在⽩⽼师和助教的课中，我们学会了如何⽤brainstorm来发散思维，提出新点⼦。; ⾸先提出⼀个⼤的概念，然后朝四周发散，可以提任何跟他相关的内容，然后再向下延 伸，直到4-5级。提出全部概念后选择可⽤的概念作为结果。; 注意事项：; 提出概念时只要有关都能提，⽆对错之分。; 注意先发散再收敛的过程，不可过度发散。; 关于外观设计的BrainStorm结果

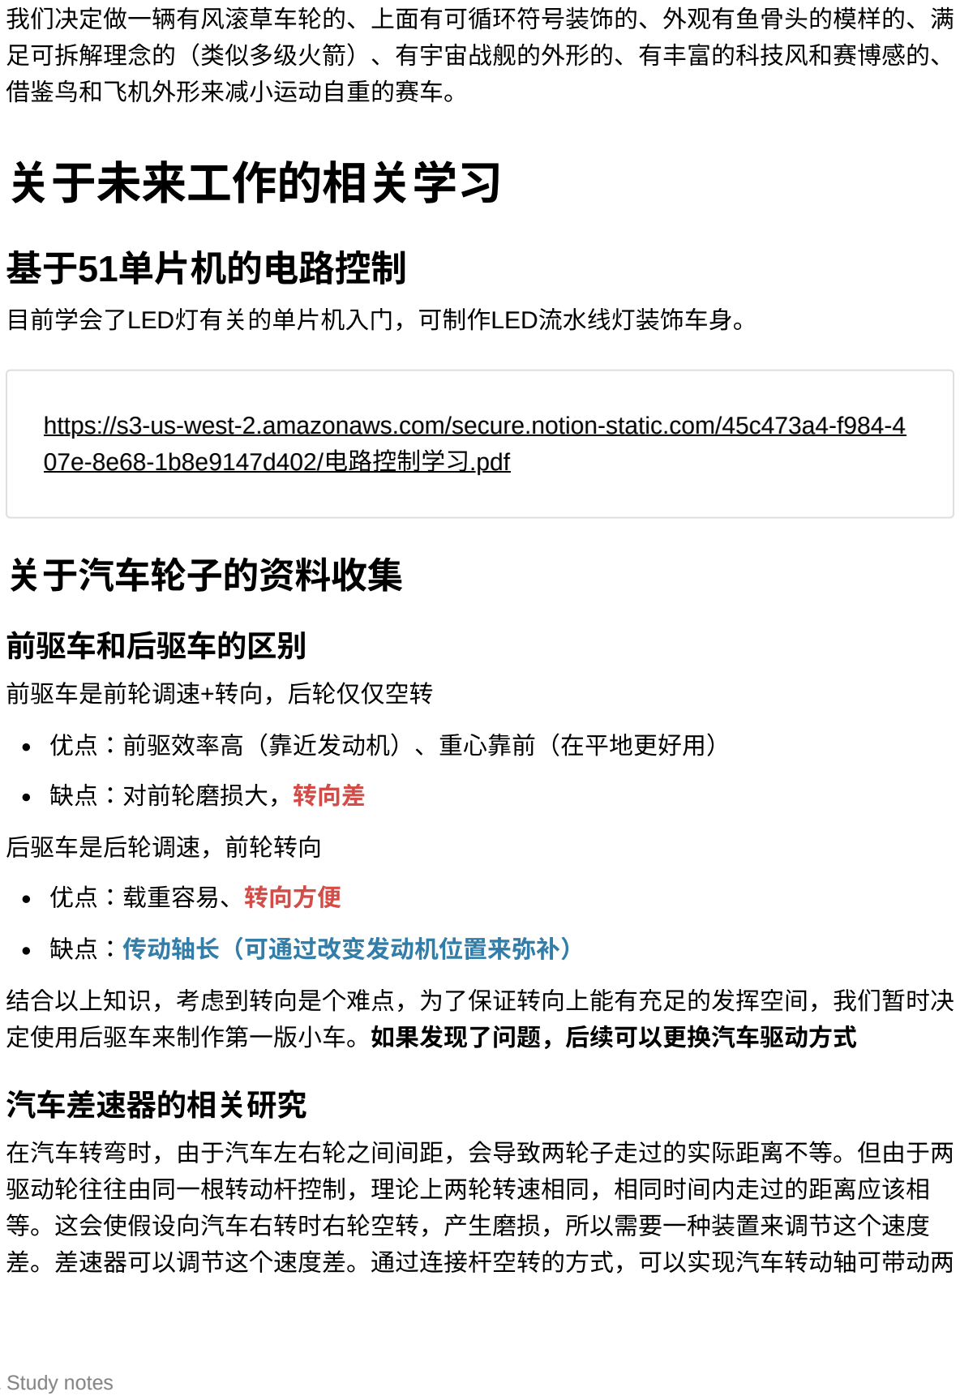
[picture p21: figure]
我们决定做⼀辆有⻛滚草⻋轮的、上⾯有可循环符号装饰的、外观有⻥⾻头的模样的、满; ⾜可拆解理念的（类似多级⽕箭）、有宇宙战舰的外形的、有丰富的科技⻛和赛博感的、; 借鉴⻦和⻜机外形来减⼩运动⾃重的赛⻋。; 关于未来⼯作的相关学习; 基于51单⽚机的电路控制; ⽬前学会了LED灯有关的单⽚机⼊门，可制作LED流⽔线灯装饰⻋⾝。; https://s3-us-west-2.amazonaws.com/secure.notion-static.com/45c473a4-f984-4 07e-8e68-1b8e9147d402/电路控制学习.pdf; 关于汽⻋轮⼦的资料收集; 前驱⻋和后驱⻋的区别; 前驱⻋是前轮调速+转向，后轮仅仅空转; 优点：前驱效率⾼（靠近发动机）、重⼼靠前（在平地更好⽤）; 缺点：对前轮磨损⼤，转向差; 后驱⻋是后轮调速，前轮转向; 优点：载重容易、转向⽅便; 缺点：传动轴⻓（可通过改变发动机位置来弥补）; 结合以上知识，考虑到转向是个难点，为了保证转向上能有充⾜的发挥空间，我们暂时决; 定使⽤后驱⻋来制作第⼀版⼩⻋。如果发现了问题，后续可以更换汽⻋驱动⽅式; 汽⻋差速器的相关研究; 在汽⻋转弯时，由于汽⻋左右轮之间间距，会导致两轮⼦⾛过的实际距离不等。但由于两; 驱动轮往往由同⼀根转动杆控制，理论上两轮转速相同，相同时间内⾛过的距离应该相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

驱动轮，两驱动轮在某⼀轮产⽣相对运动时单独⼯作。在本项⽬⾥的具体实现可以通过冰 棍杆链接成简单的差速器，详⻅下图

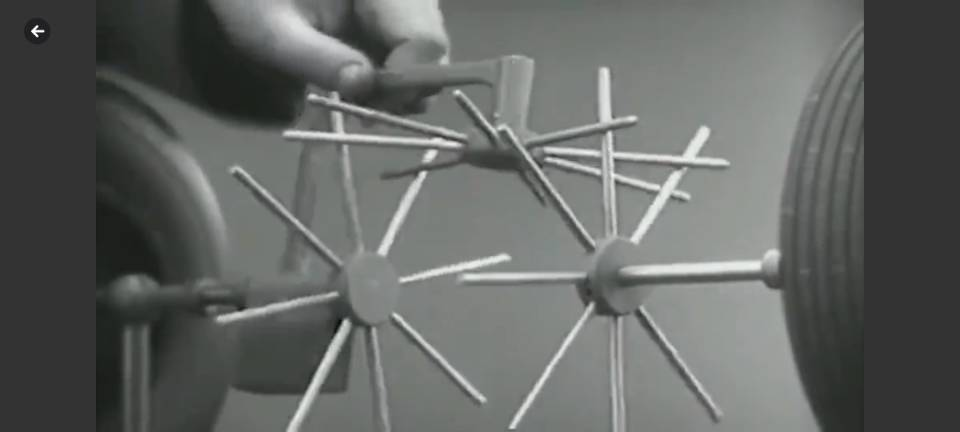
[picture p22: figure]

# 第⼀周总结

第⼀周⾥学习了有关设计、材料、美学等相关知识，提升了硬实⼒。从开营时⼤家的毫⽆ 头绪，到现在我们⼩组已经有了赛⻋的雏形以及⼤概明确了未来五周的努⼒⽅向。在⼩组 ⾥我⾃愿成为了组⻓，虽然我没有很强的专业能⼒，但我任然希望⾃⼰能带领⼩组完成任 务，因此我需要⾃⼰多学习⼀些相关知识来指导组员们的操作。第⼀周还学习了很多软件 的操作，⽐如学⻓分享的notion、latex、eagle等软件对我受益匪浅，学好了他们有利于 我今后所有课程的学习。

第⼀周是⼀个不错的开始，希望接下来也能和⼩组成员⼀起努⼒，完成我们的作品！
