Kannospark/Eco-friendly-racing-cars/Final Report & Experience/images/2.jpg

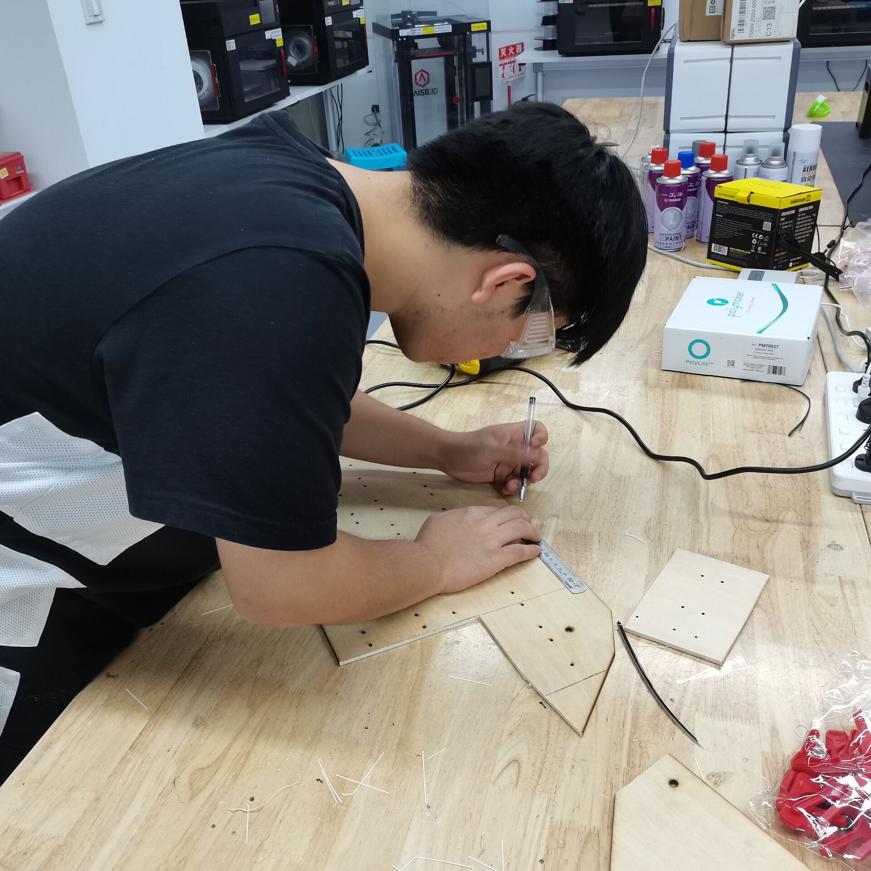
Final Report & Experience/images/2.jpg
