Kannospark/Eco-friendly-racing-cars/Final Report & Experience/images/3.jpg

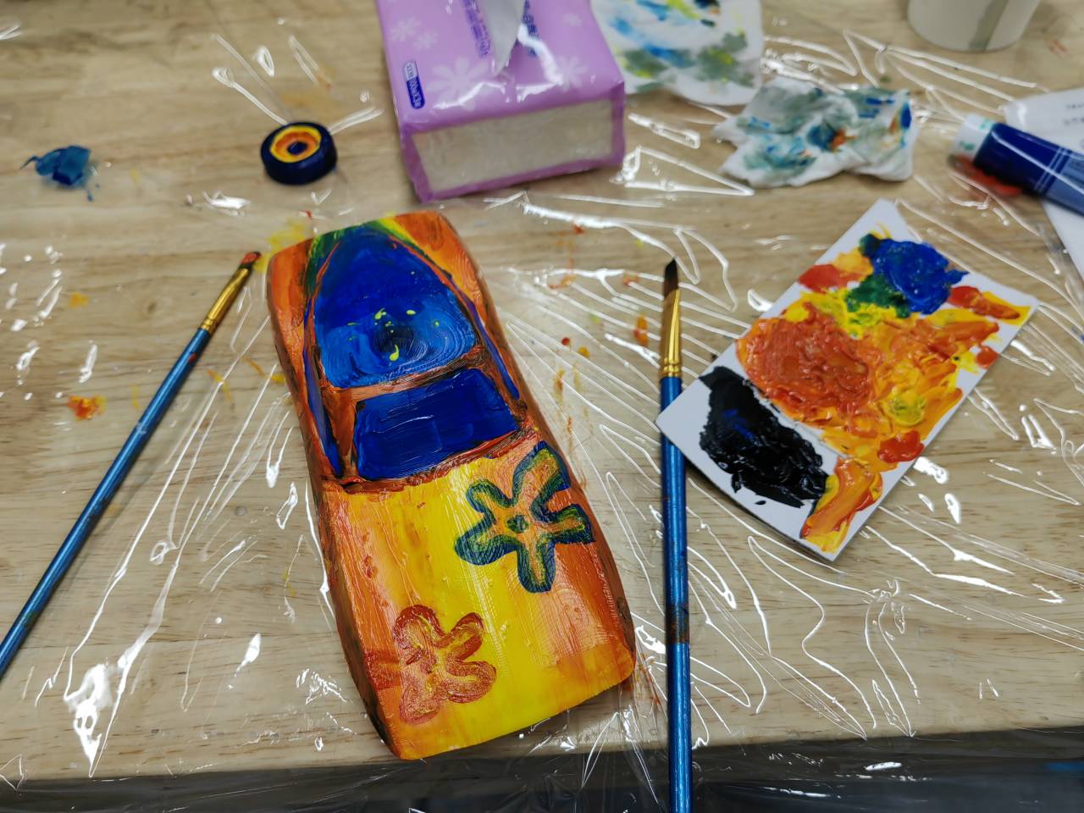
Final Report & Experience/images/3.jpg
