Kannospark/Eco-friendly-racing-cars/Final Report & Experience/images/4.jpg

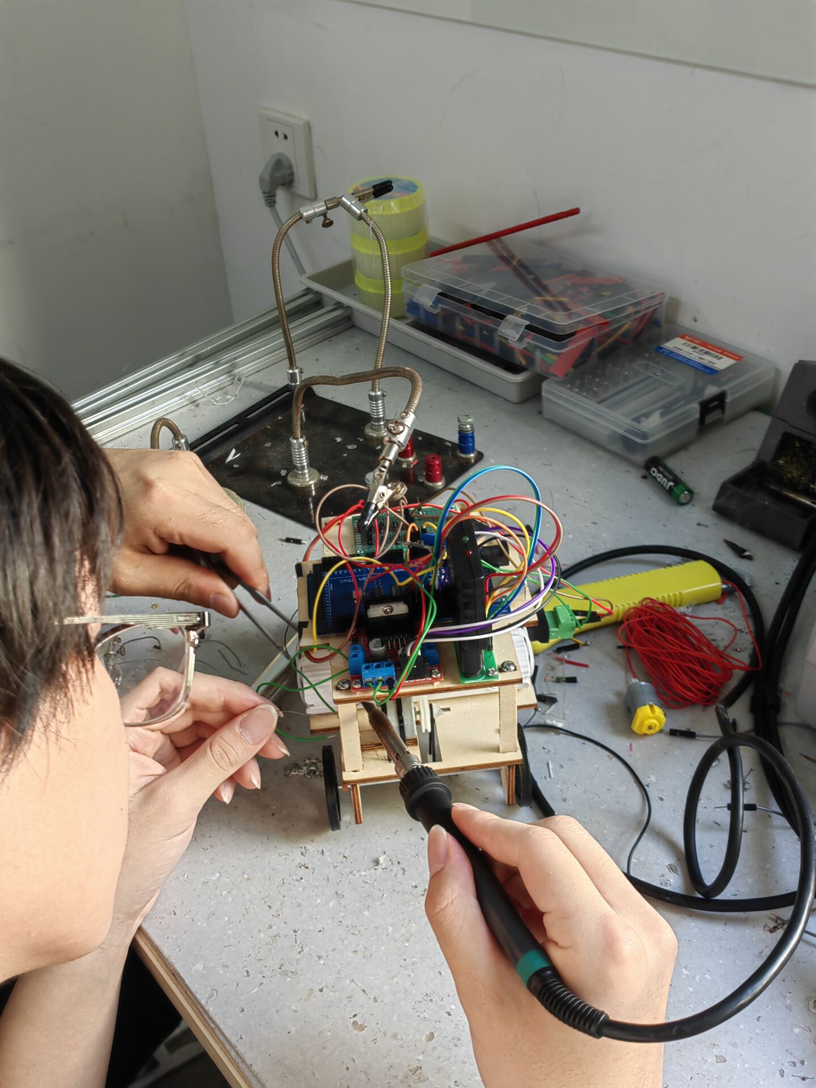
Final Report & Experience/images/4.jpg
