Kannospark/Eco-friendly-racing-cars/Final Report & Experience/images/5.jpg

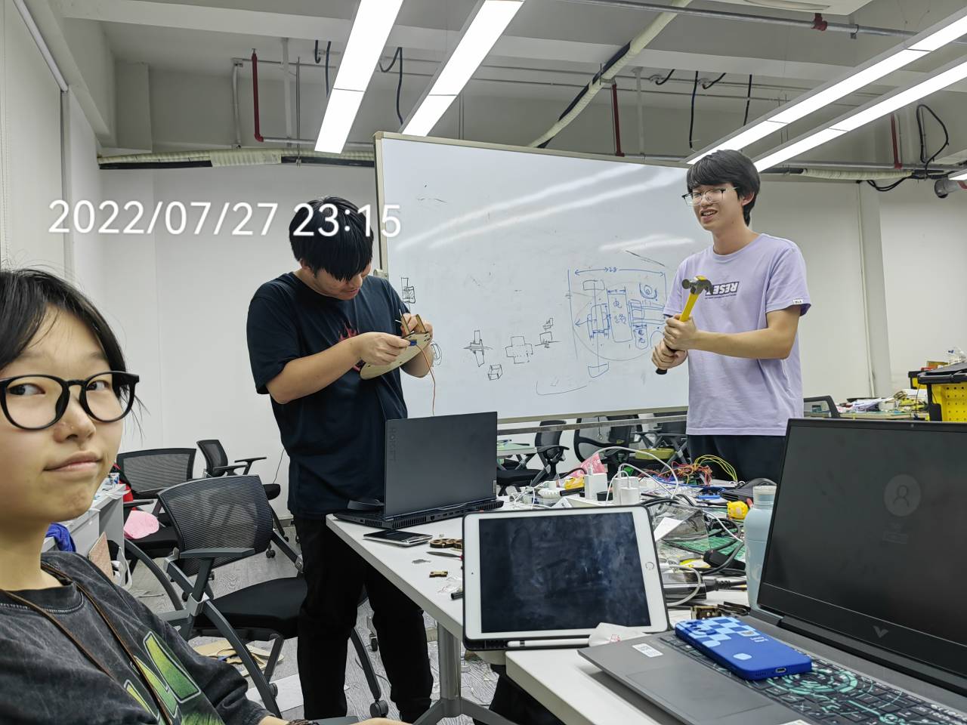
Final Report & Experience/images/5.jpg
