Kannospark/Eco-friendly-racing-cars/Final Report & Experience/images/6.jpg

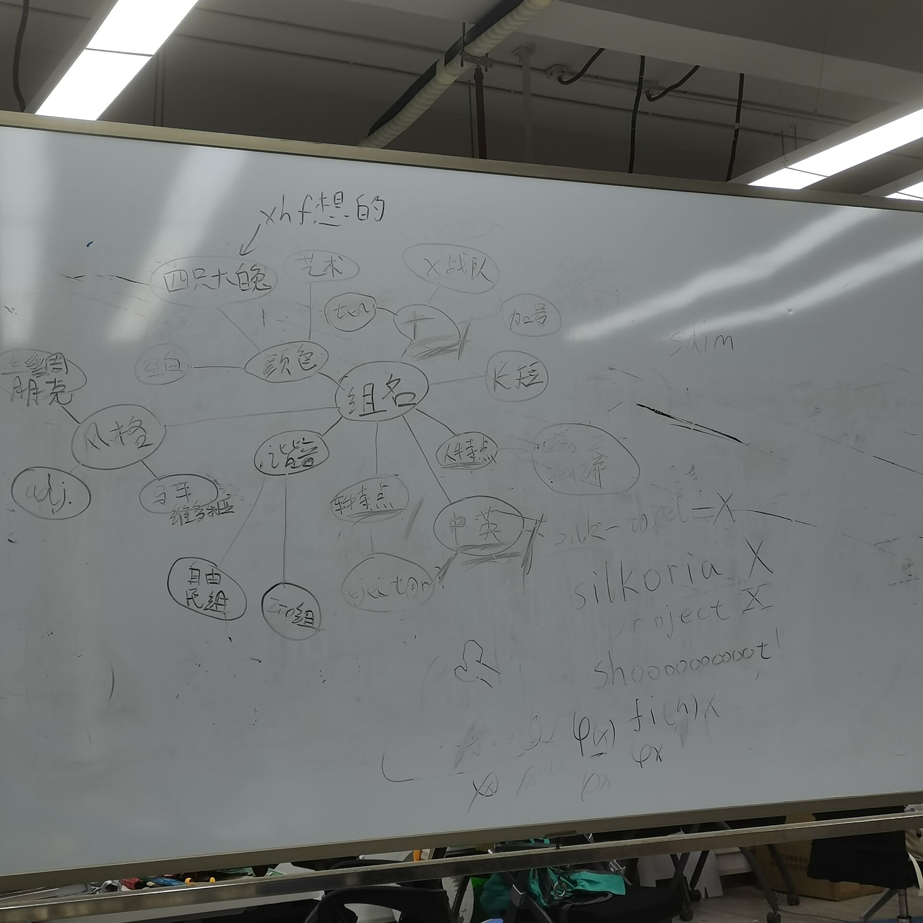
Final Report & Experience/images/6.jpg
