Kannospark/Eco-friendly-racing-cars/Final Report & Experience/images/7.jpg

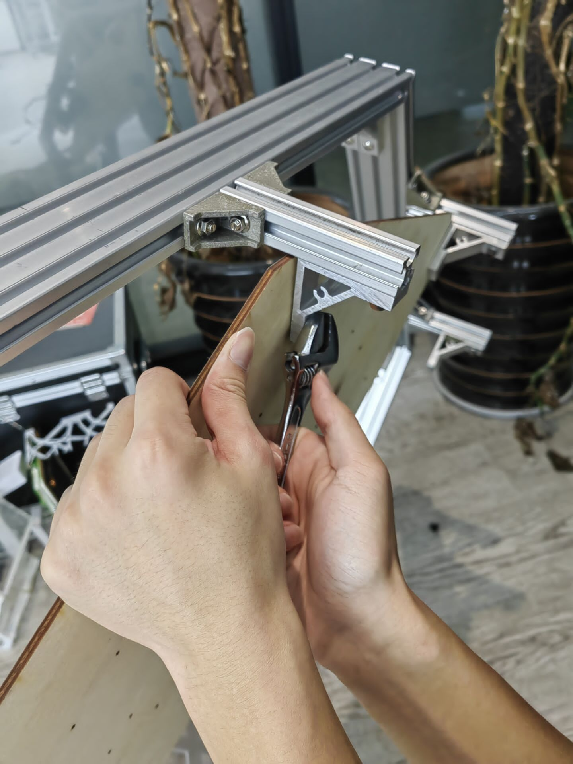
Final Report & Experience/images/7.jpg
