Kannospark/Eco-friendly-racing-cars/Final Report & Experience/images/8.jpg

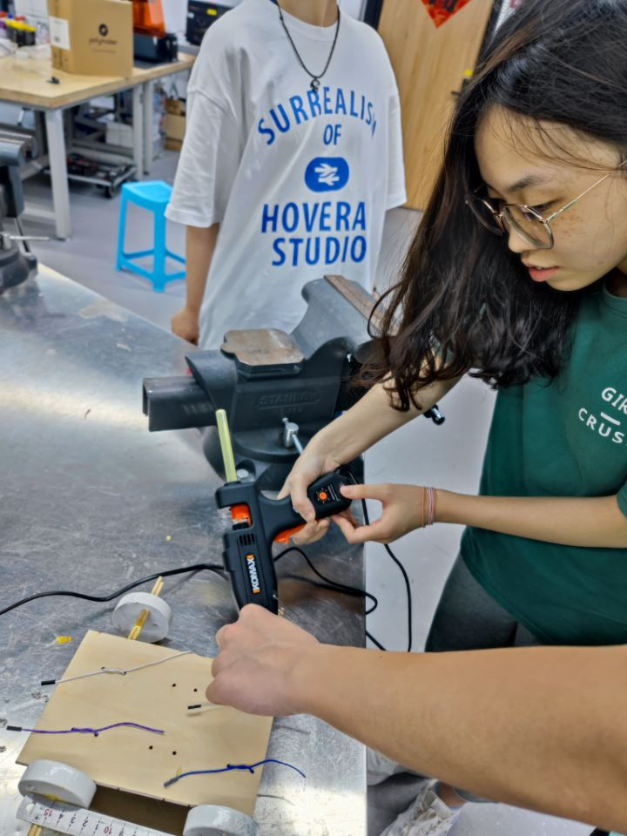
Final Report & Experience/images/8.jpg
