Kannospark/Eco-friendly-racing-cars/Final Report & Experience/images/9.png

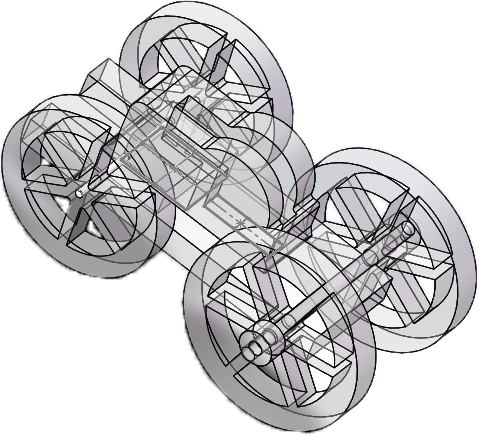
Final Report & Experience/images/9.png
