Kannospark/Eco-friendly-racing-cars/Final Report & Experience/images/10.png

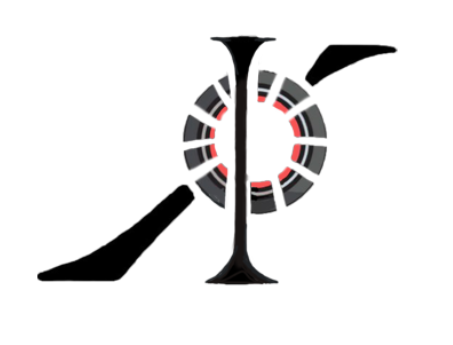
Final Report & Experience/images/10.png
