Kannospark/Eco-friendly-racing-cars/Final Report & Experience/images/12.jpg

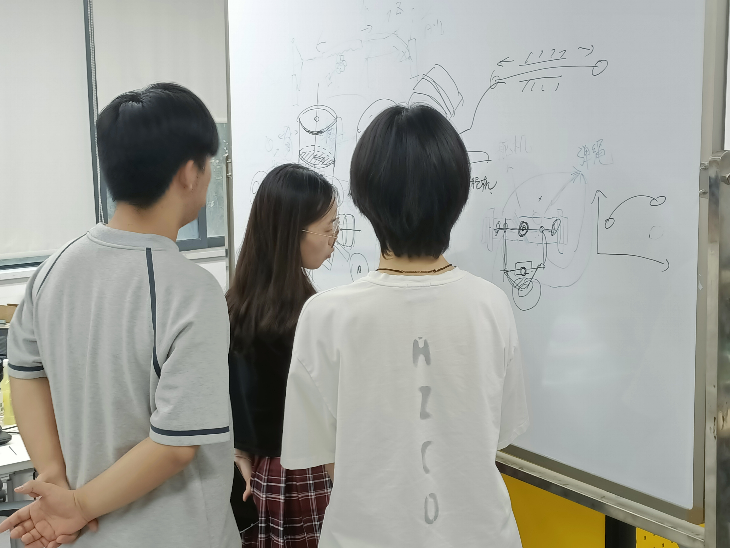
Final Report & Experience/images/12.jpg
