Kannospark/Eco-friendly-racing-cars/Final Report & Experience/images/13.jpg

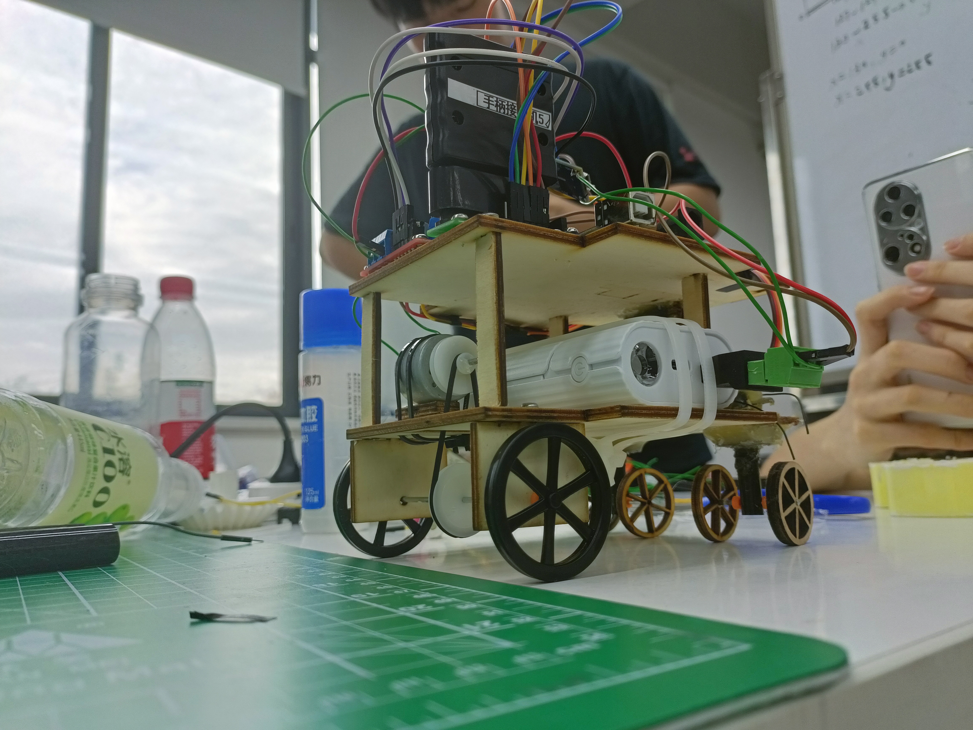
Final Report & Experience/images/13.jpg
