Kannospark/Eco-friendly-racing-cars/Final Report & Experience/images/15.jpg

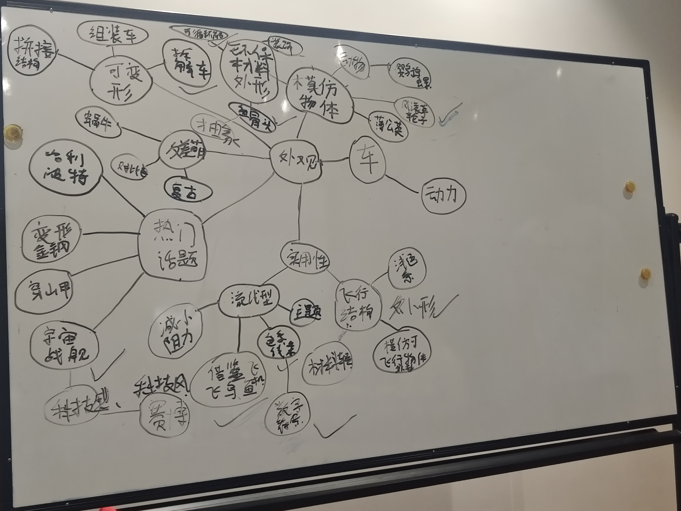
Final Report & Experience/images/15.jpg
