Kannospark/Eco-friendly-racing-cars/Final Report & Experience/Final Presentation.pdf

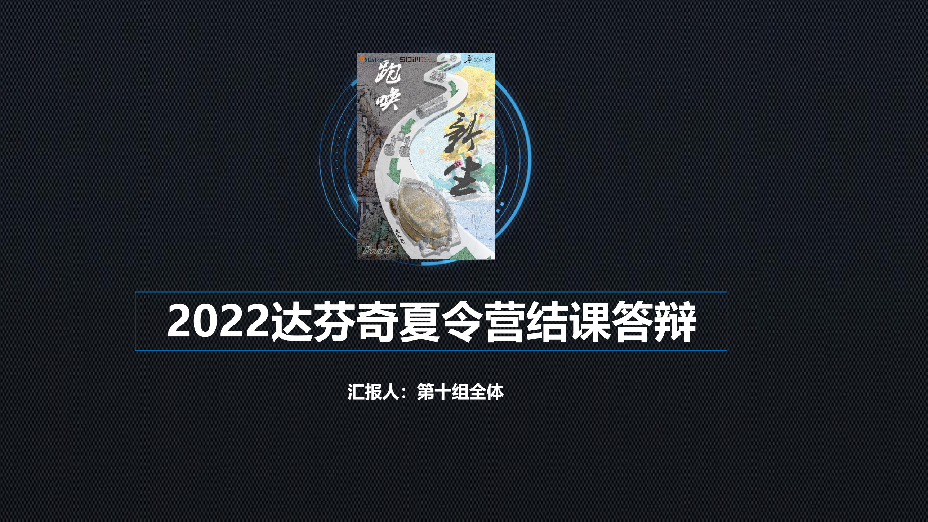
[picture p35: page 1]

# 2022达芬奇夏令营结课答辩

### 汇报人：第十组全体

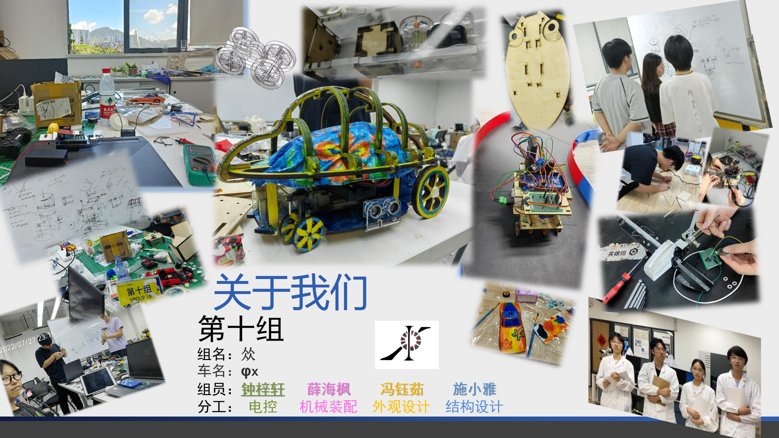
[picture p36: page 2]

# 关于我们

# 第十组

组名：𠈌
车名：φx
组员：钟梓轩 | 薛海枫 | 冯钰茹 | 施小雅
分工： 电控 | 机械装配 外观设计 结构设计

目录

# Contents

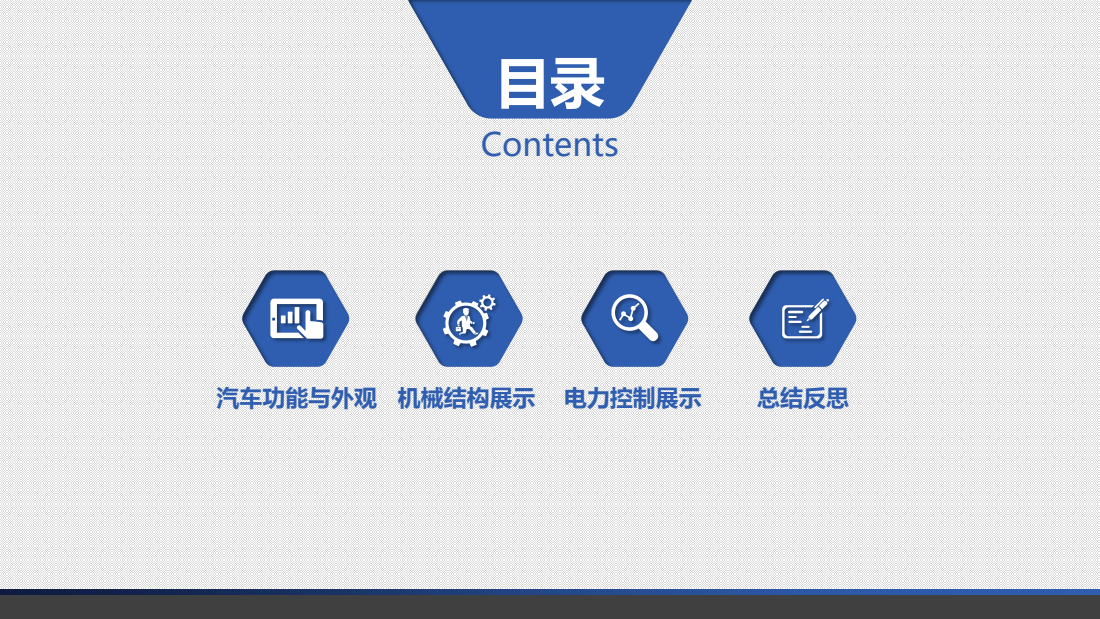
[picture p37: page 3]
汽车功能与外观 机械结构展示 电力控制展示; 总结反思

### 汽车功能与外观

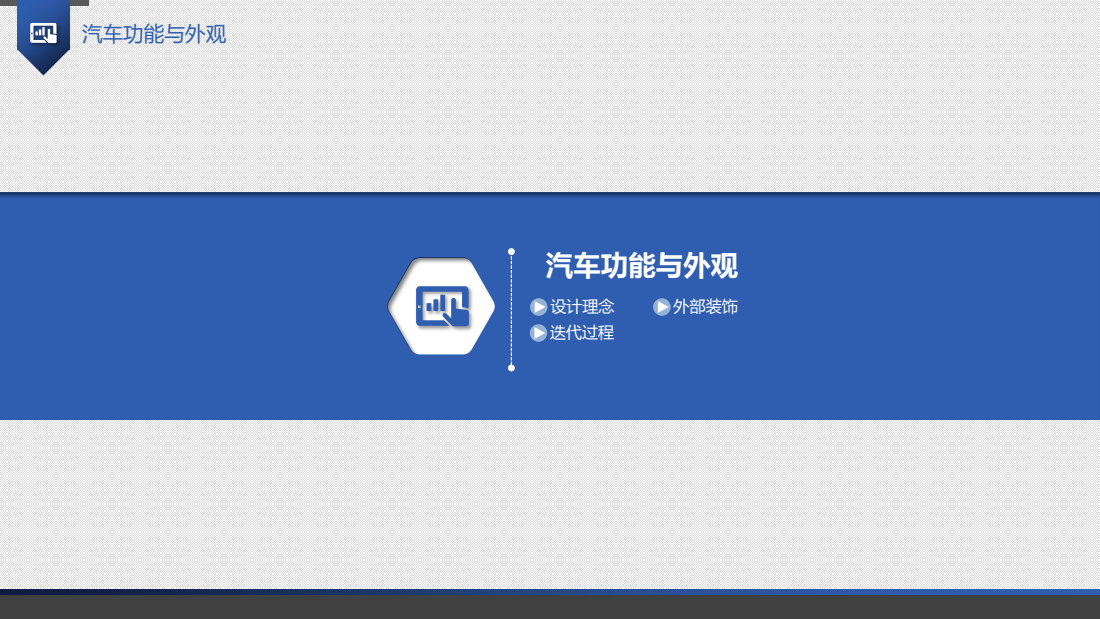
[picture p38: page 4]
汽车功能与外观; 设计理念; 外部装饰; 迭代过程

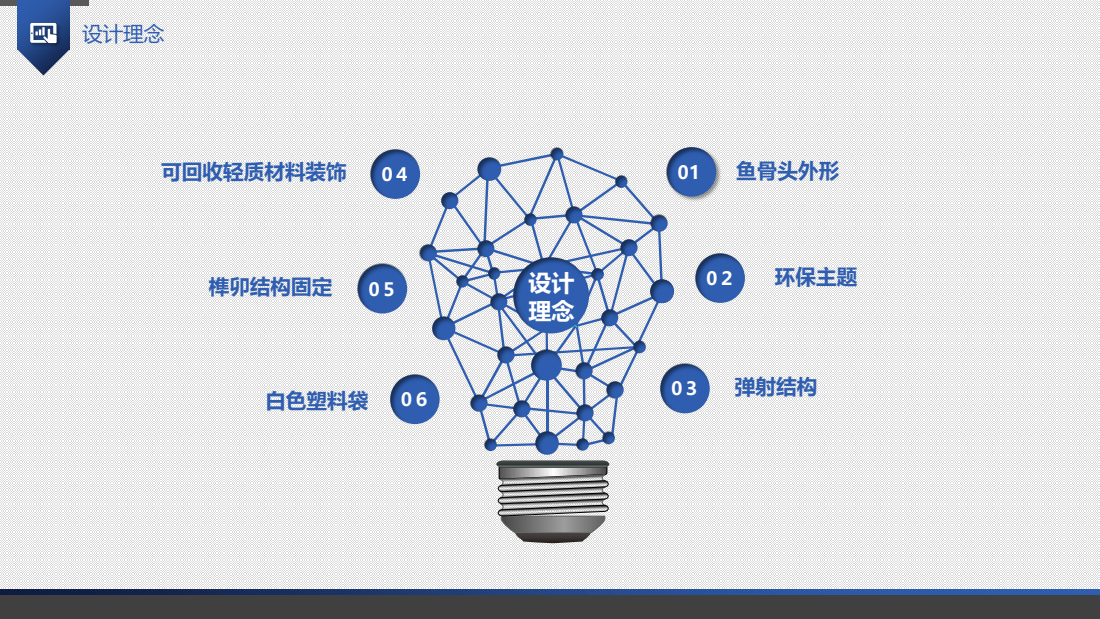
[picture p39: page 5]
设计理念; 01 鱼骨头外形; 0２ 环保主题; 0３ 弹射结构; 可回收轻质材料装饰; 榫卯结构固定; 白色塑料袋

### 外部装饰

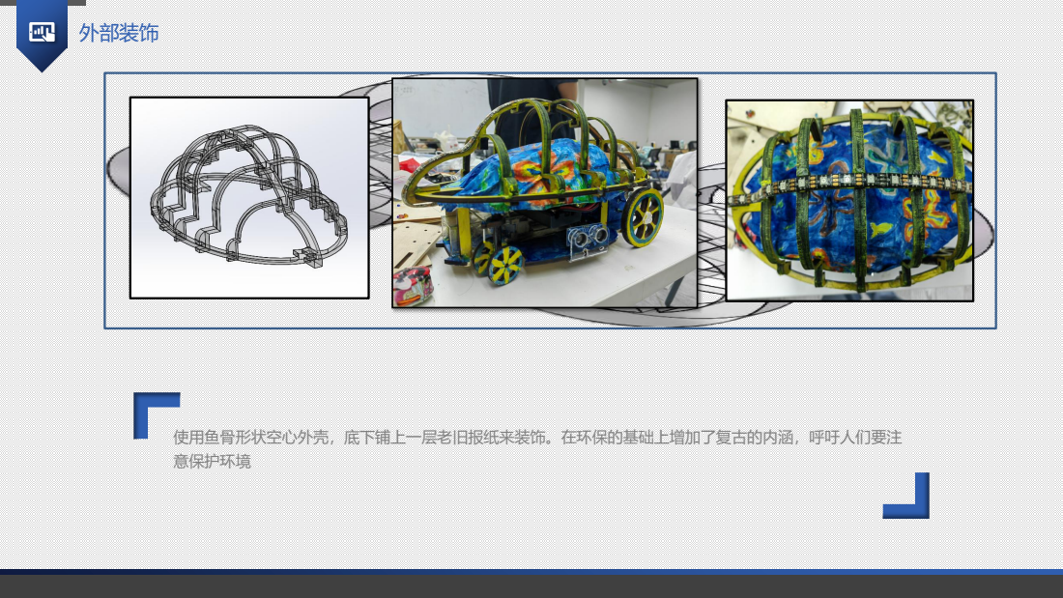
[picture p40: page 6]

使用鱼骨形状空心外壳，底下铺上一层老旧报纸来装饰。在环保的基础上增加了复古的内涵，呼吁人们要注
意保护环境

### 迭代过程

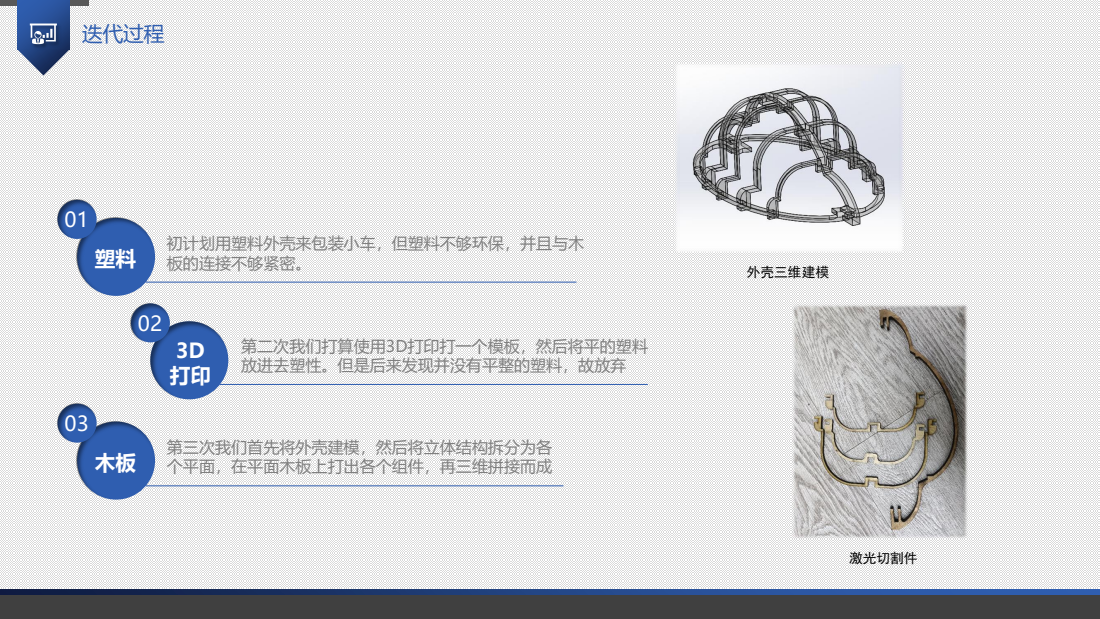
[picture p41: page 7]
外壳三维建模; 激光切割件

初计划用塑料外壳来包装小车，但塑料不够环保，并且与木
板的连接不够紧密。

第二次我们打算使用3D打印打一个模板，然后将平的塑料
放进去塑性。但是后来发现并没有平整的塑料，故放弃

第三次我们首先将外壳建模，然后将立体结构拆分为各
个平面，在平面木板上打出各个组件，再三维拼接而成

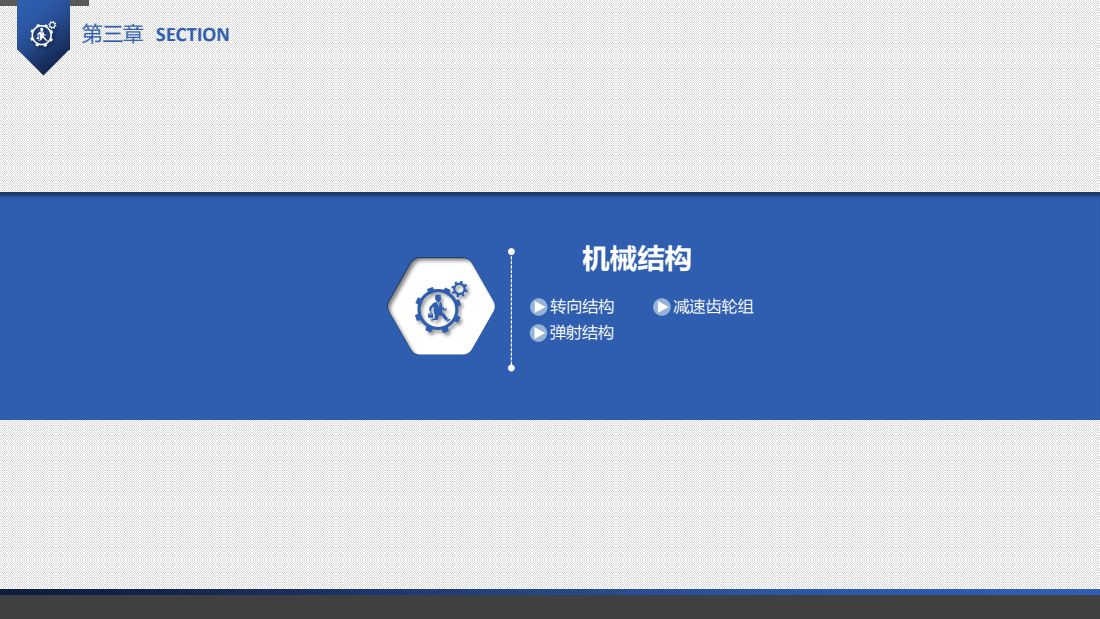
[picture p42: page 8]
机械结构; 转向结构; 减速齿轮组; 弹射结构; 第三章 SECTION

### 转向结构

### 从细铁线连接到铁杆连接

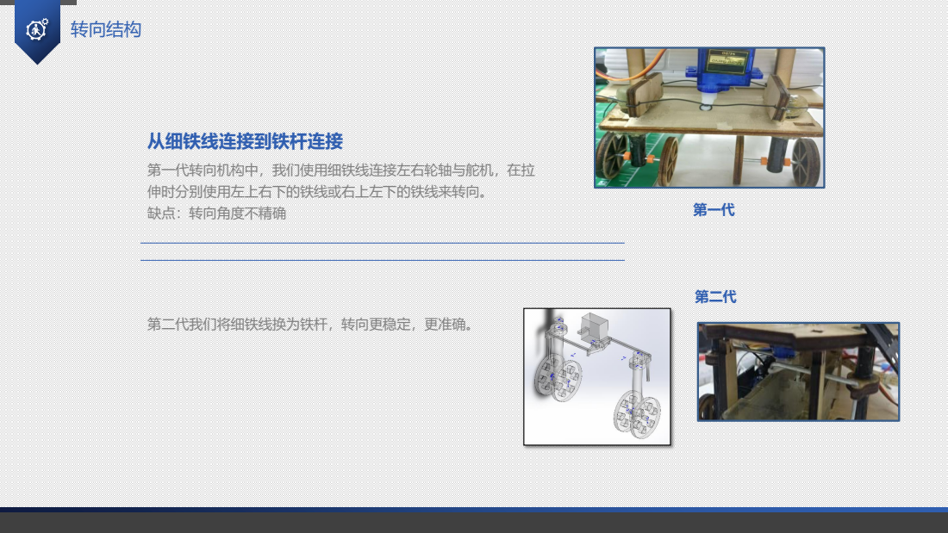
[picture p43: page 9]
第一代; 第二代

第一代转向机构中，我们使用细铁线连接左右轮轴与舵机，在拉
伸时分别使用左上右下的铁线或右上左下的铁线来转向。
缺点：转向角度不精确

第二代我们将细铁线换为铁杆，转向更稳定，更准确。

### 减速齿轮组

### 第一代减速结构

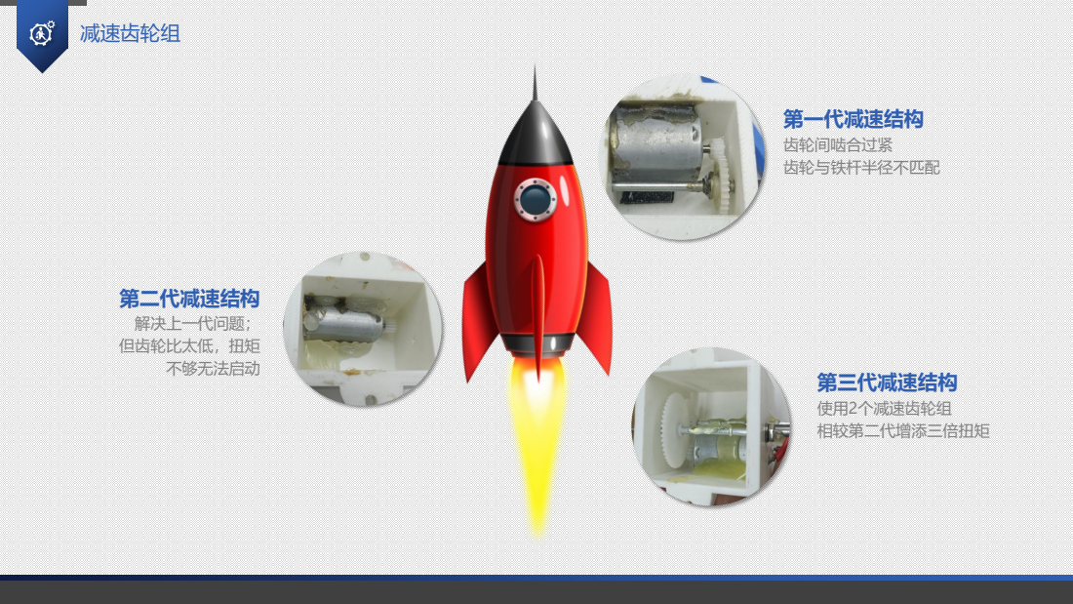
[picture p44: page 10]
齿轮间啮合过紧 齿轮与铁杆半径不匹配; 第三代减速结构; 2个减速齿轮组 相较第二代增添三倍扭矩; 第二代减速结构; 解决上一代问题； 但齿轮比太低，扭矩 不够无法启动

### 弹射系统介绍

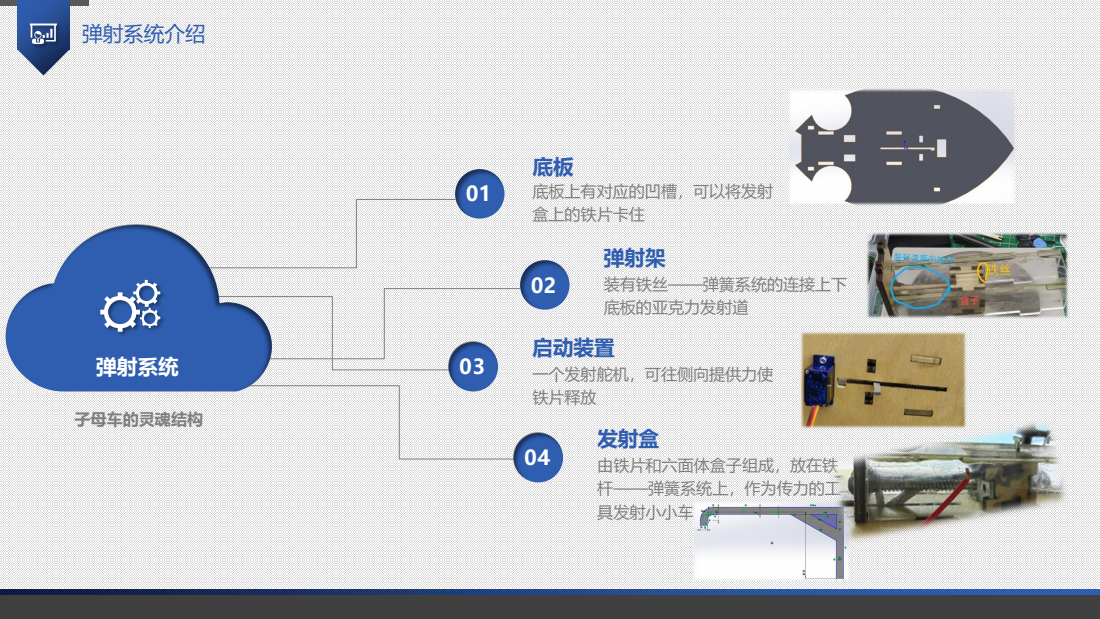
[picture p45: page 11]
弹射系统; 子母车的灵魂结构; 底板上有对应的凹槽，可以将发射 盒上的铁片卡住; 装有铁丝——弹簧系统的连接上下 底板的亚克力发射道; 启动装置; 一个发射舵机，可往侧向提供力使 铁片释放; 发射盒; 由铁片和六面体盒子组成，放在铁 杆——弹簧系统上，作为传力的工 具发射小小车; 弹射架

### 弹射系统——第一第二代对比

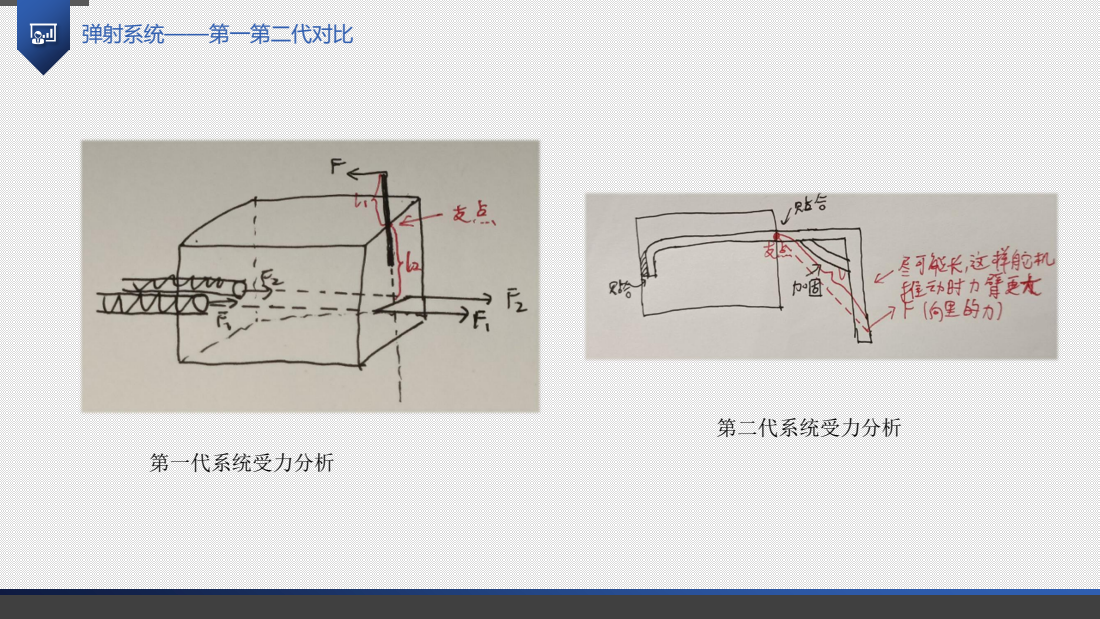
[picture p46: page 12]
第一代系统受力分析; 第二代系统受力分析

### 电力控制部分

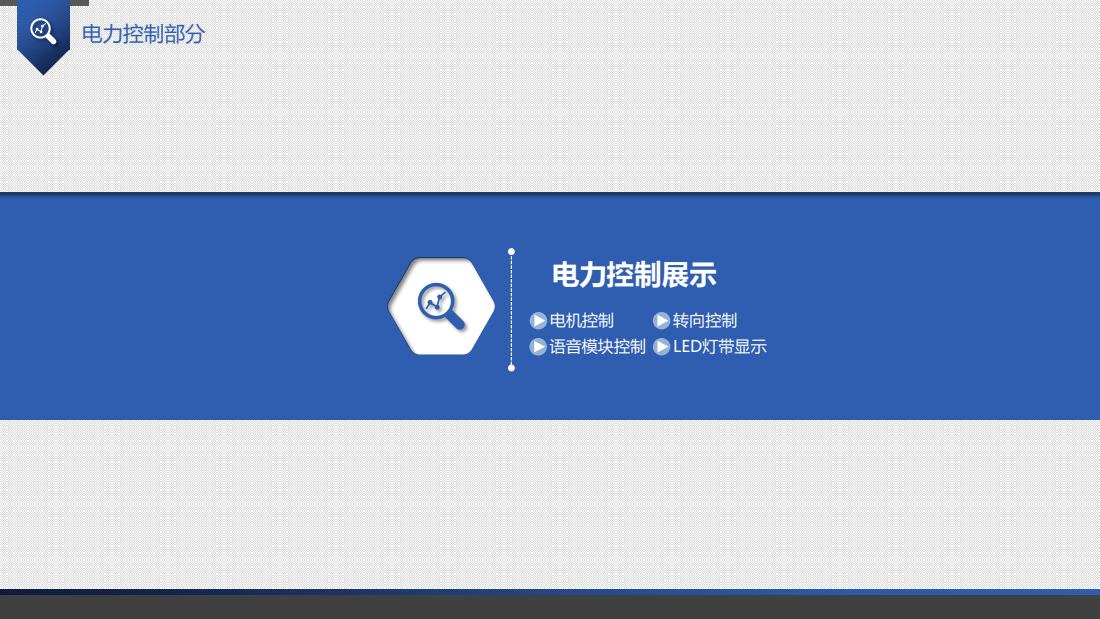
[picture p47: page 13]
电力控制展示; 电机控制; 转向控制; 语音模块控制; LED灯带显示

### 电机控制

### 多次迭代

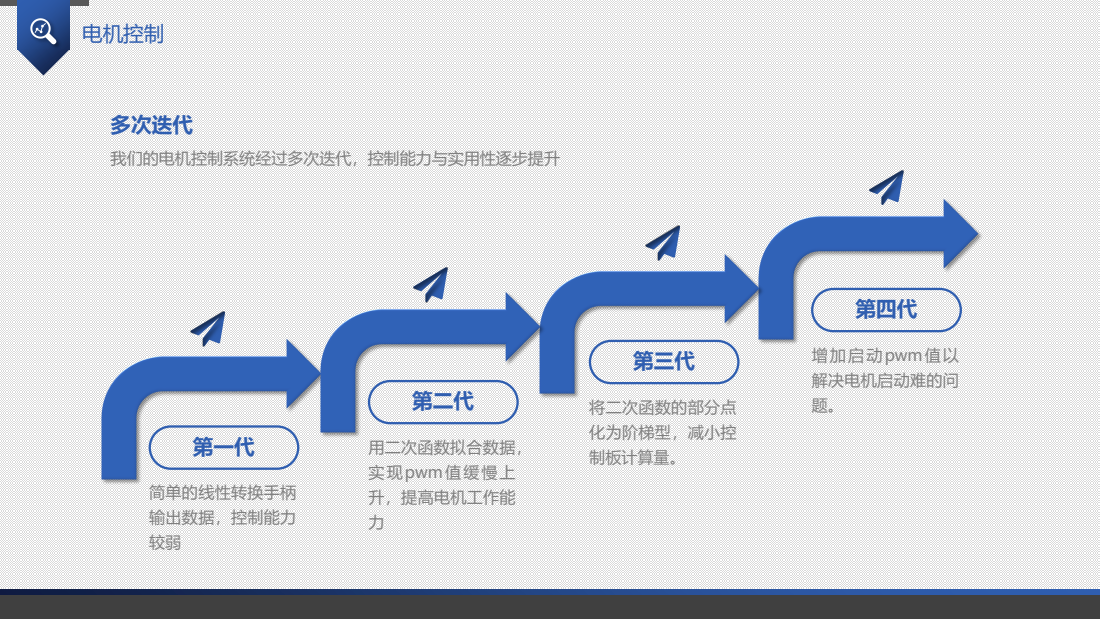
[picture p48: page 14]
第一代; 简单的线性转换手柄 输出数据，控制能力 较弱; 第二代; 用二次函数拟合数据， 实现pwm值缓慢上 升，提高电机工作能 力; 第三代; 将二次函数的部分点 化为阶梯型，减小控 制板计算量。; 第四代; 增加启动pwm值以 解决电机启动难的问 题。; 我们的电机控制系统经过多次迭代，控制能力与实用性逐步提升

### 转向控制

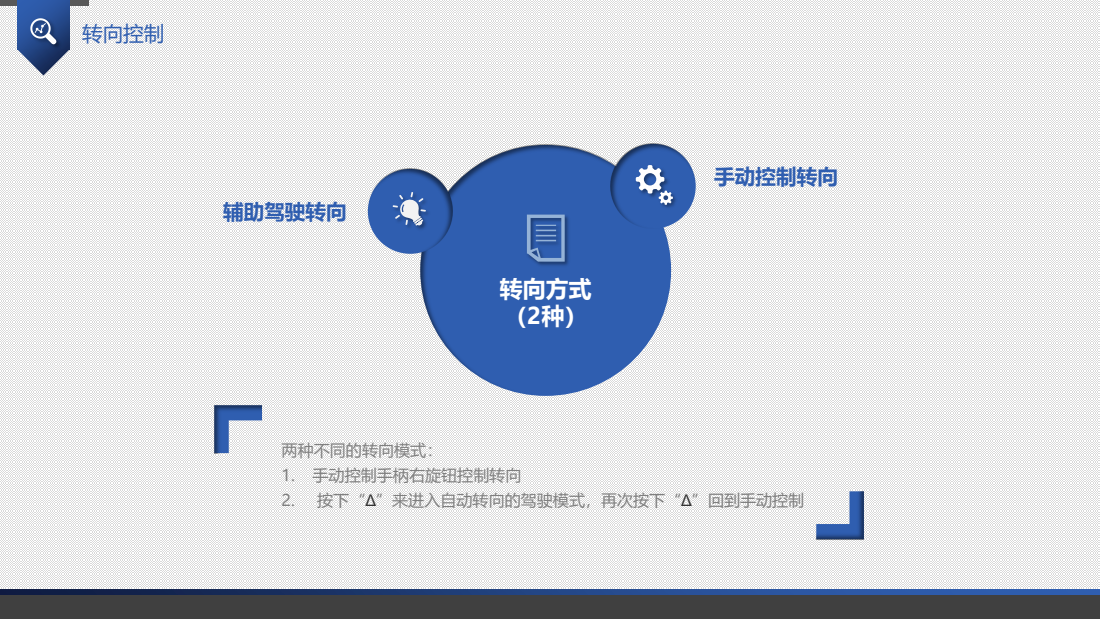
[picture p49: page 15]
转向方式 （2种）; 手动控制转向; 辅助驾驶转向

两种不同的转向模式：
1. 手动控制手柄右旋钮控制转向
2. 按下“Δ”来进入自动转向的驾驶模式，再次按下“Δ”回到手动控制

### 语音模块控制

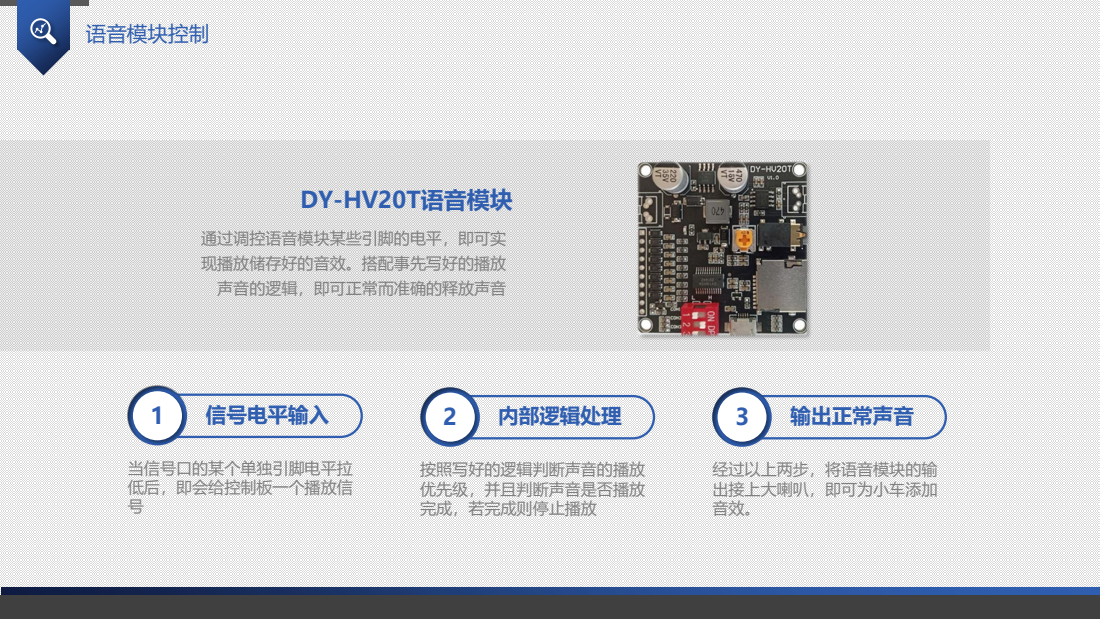
[picture p50: page 16]
DY-HV20T语音模块; 通过调控语音模块某些引脚的电平，即可实 现播放储存好的音效。搭配事先写好的播放 声音的逻辑，即可正常而准确的释放声音; 信号电平输入; 当信号口的某个单独引脚电平拉 低后，即会给控制板一个播放信 号; 1 内部逻辑处理; 按照写好的逻辑判断声音的播放 优先级，并且判断声音是否播放 完成，若完成则停止播放; 2 输出正常声音; 经过以上两步，将语音模块的输 出接上大喇叭，即可为小车添加 音效。

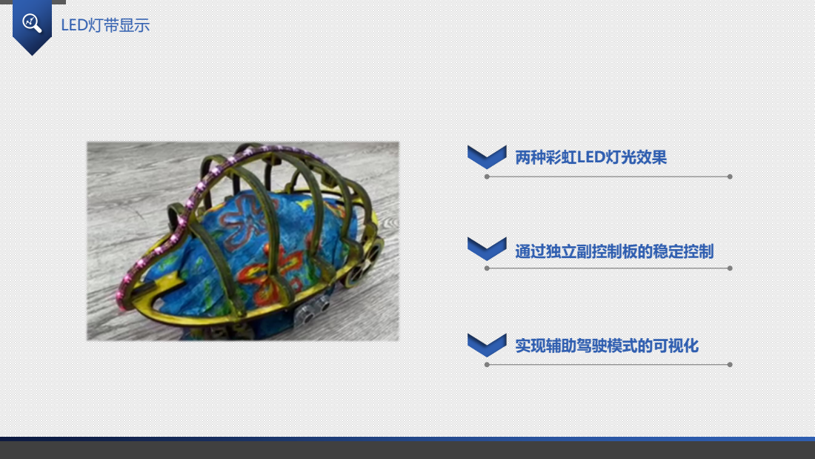
[picture p51: page 17]
LED灯带显示; 两种彩虹LED灯光效果; 通过独立副控制板的稳定控制; 实现辅助驾驶模式的可视化

### 总结反思

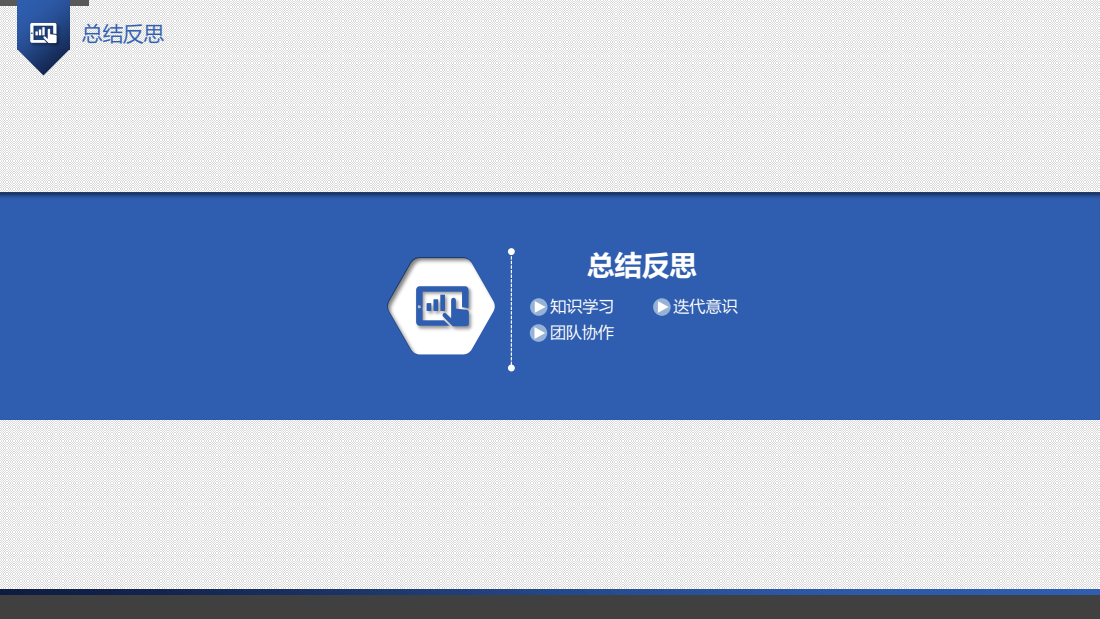
[picture p52: page 18]
总结反思; 知识学习; 迭代意识; 团队协作

### 知识学习

### 电路设计

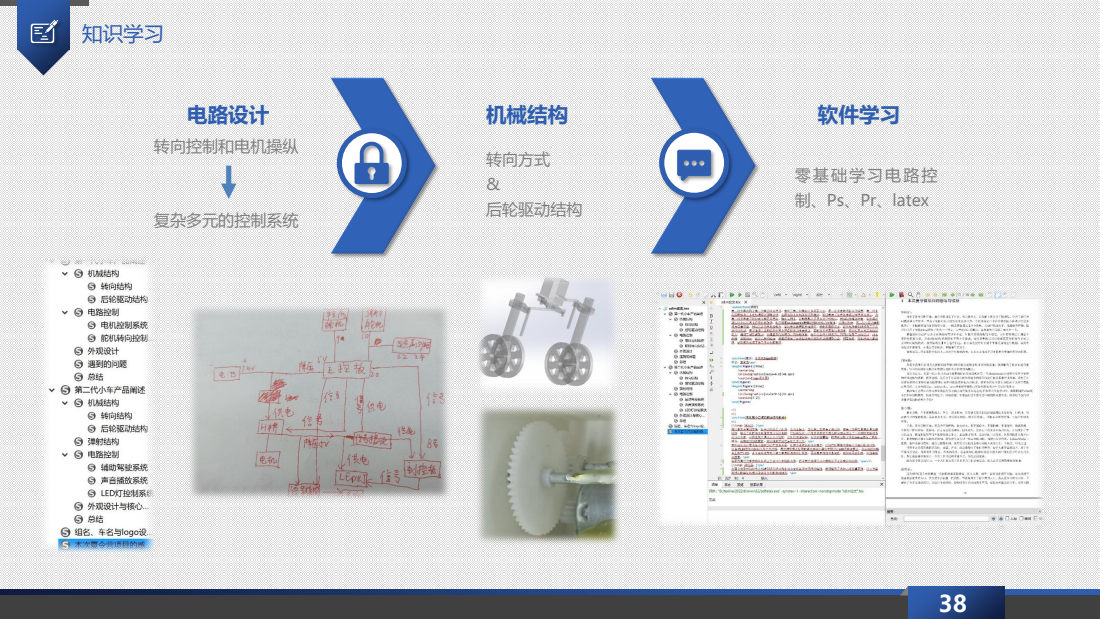
[picture p53: page 19]
转向控制和电机操纵; 机械结构; 转向方式 & 后轮驱动结构; 软件学习; 复杂多元的控制系统

零基础学习电路控
制、Ps、Pr、latex

### 迭代意识

### 建模尺寸检查

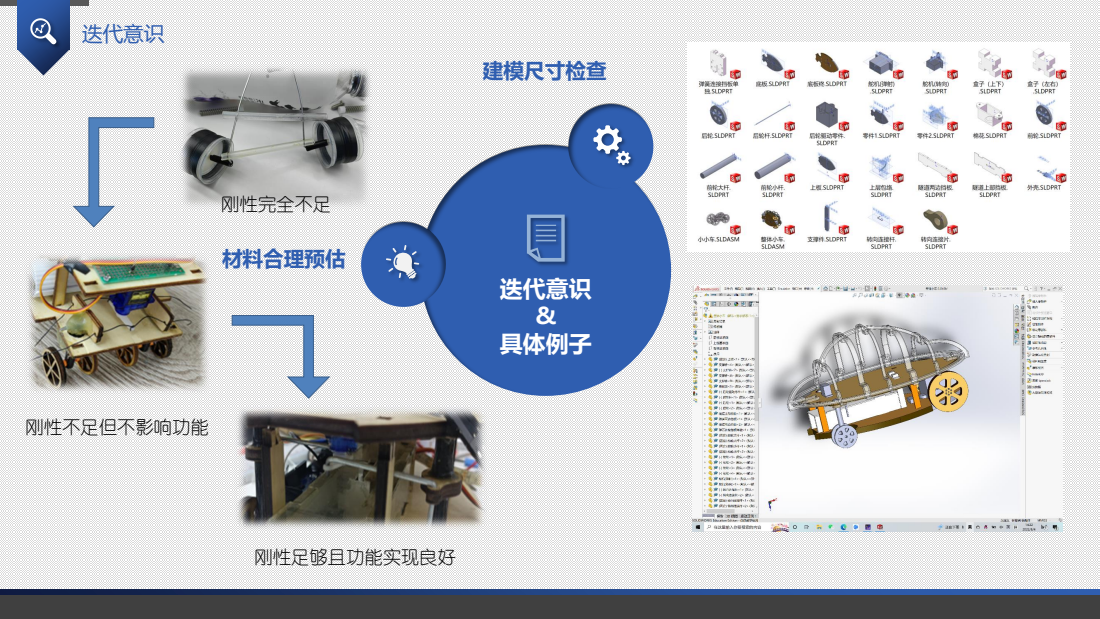
[picture p54: page 20]
迭代意识 & 具体例子; 材料合理预估; 刚性完全不足; 刚性不足但不影响功能; 刚性足够且功能实现良好

### 团队协作

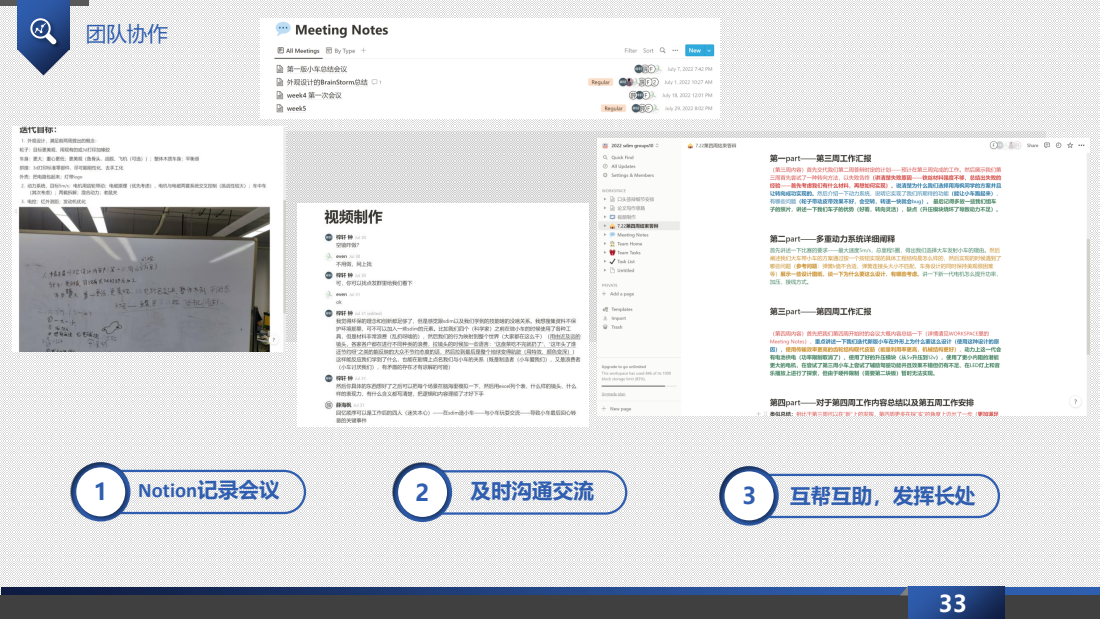
[picture p55: page 21]
Notion记录会议; 及时沟通交流; 互帮互助，发挥长处

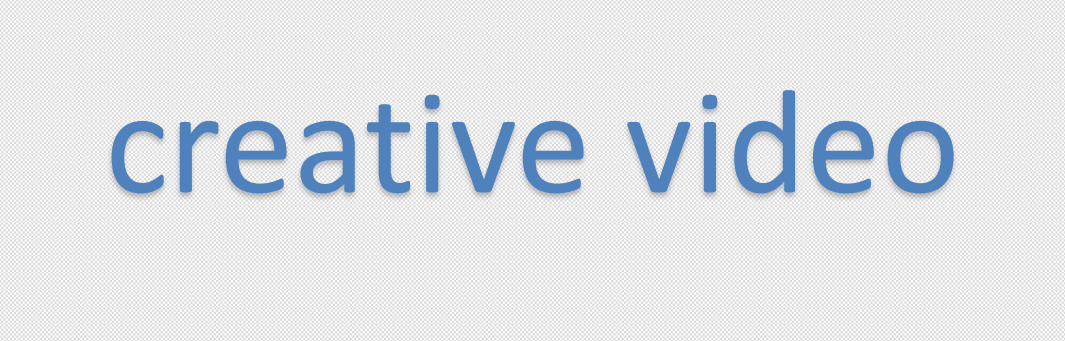
[picture p56: figure]
creative video
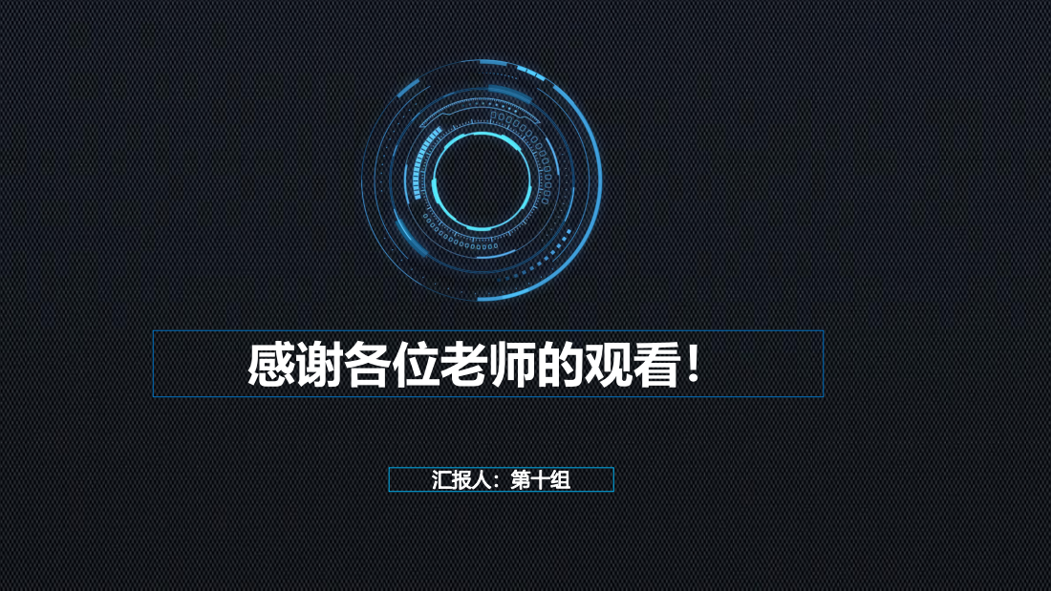
[picture p57: page 23]
感谢各位老师的观看！; 汇报人：第十组

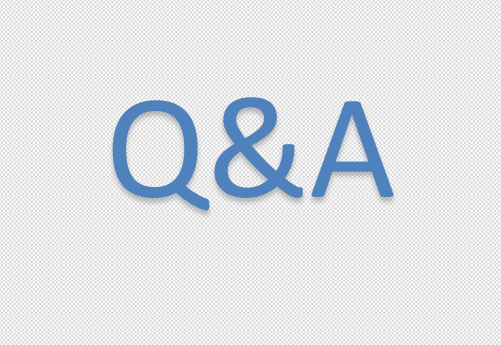
[picture p58: figure]
